sagdusmir/GasBuddy-Display-320x172/misc/3d-models/strain relief/printed part.jpg

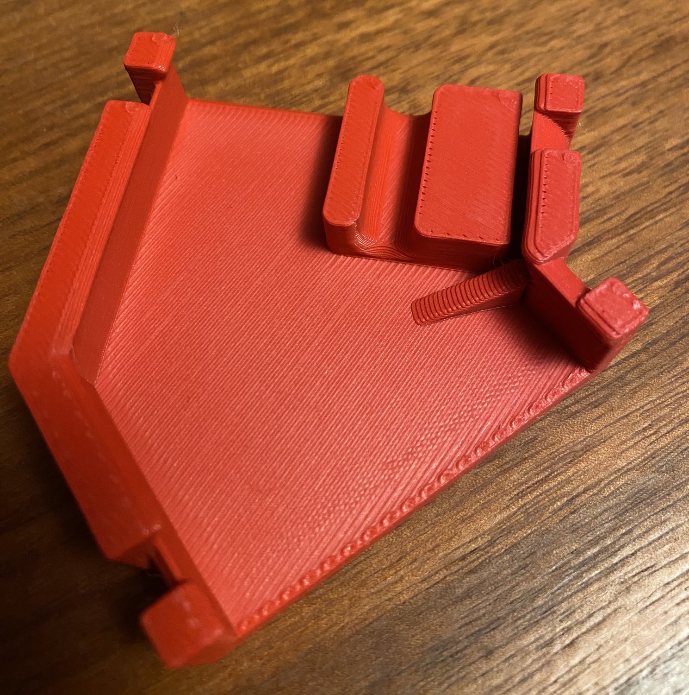
misc/3d-models/strain relief/printed part.jpg
