sagdusmir/GasBuddy-Display-320x172/misc/3d-models/strain relief/mounted part.jpg

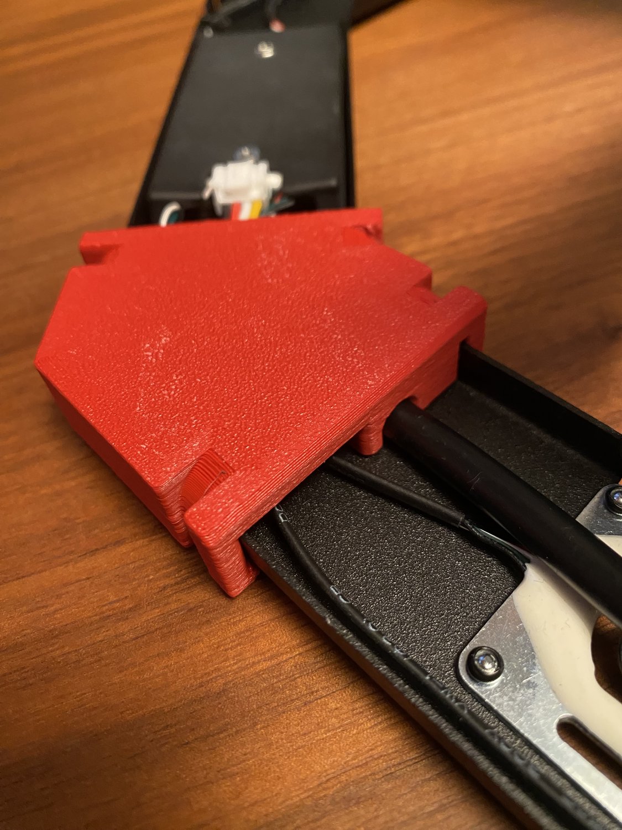
misc/3d-models/strain relief/mounted part.jpg
