sagdusmir/GasBuddy-Display-320x172/misc/3d-models/strain relief/strain relief v7.png

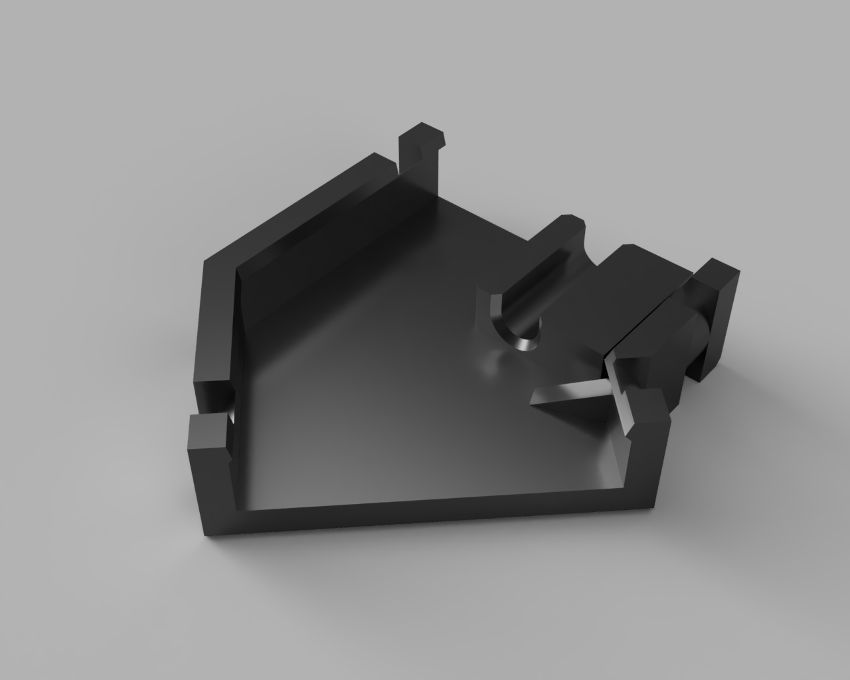
misc/3d-models/strain relief/strain relief v7.png
