sagdusmir/GasBuddy-Display-320x172/misc/part_magnetic_pogo_connector_4p_with_ear.png

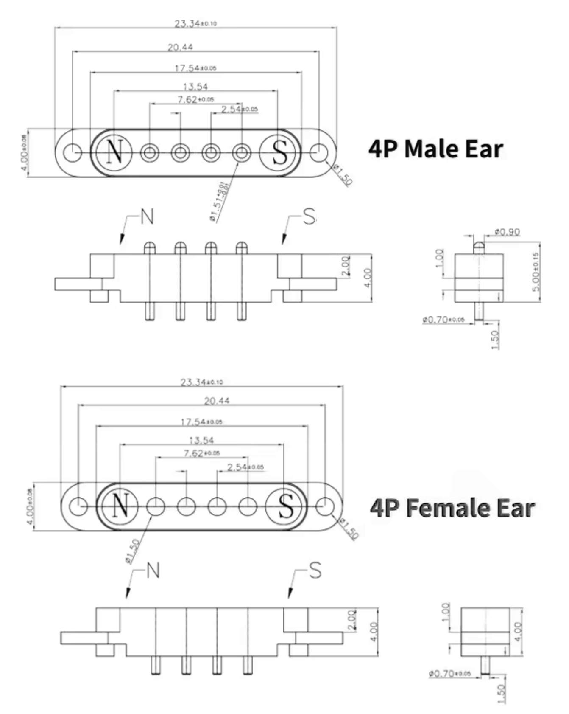
misc/part_magnetic_pogo_connector_4p_with_ear.png
