sagdusmir/GasBuddy-Display-320x172/misc/pcb-shield-v1.2/renders/top.png

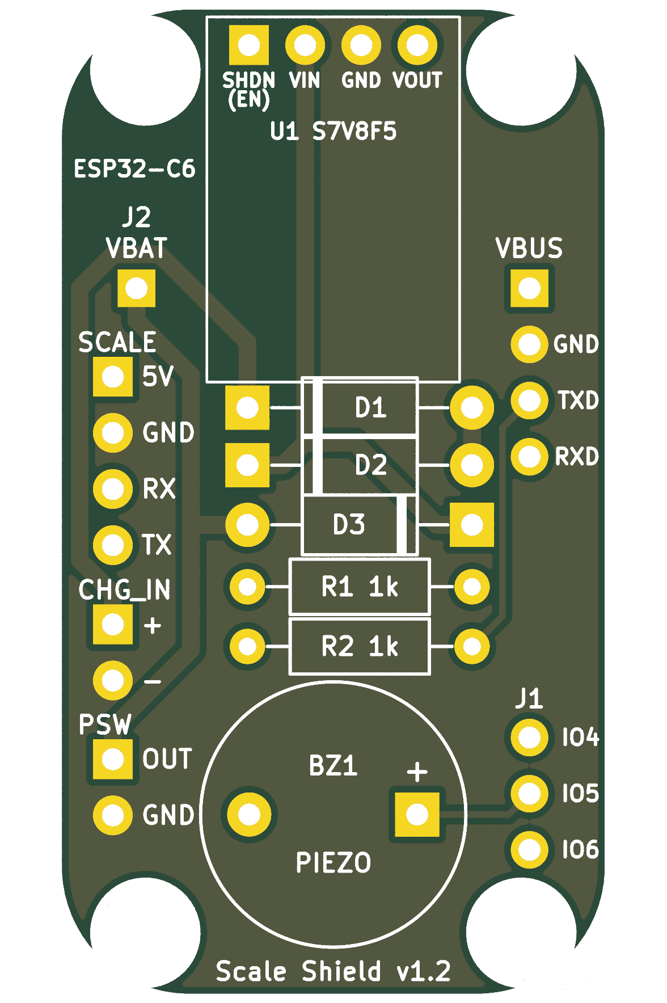
misc/pcb-shield-v1.2/renders/top.png
