sagdusmir/GasBuddy-Display-320x172/misc/3d-models/strain relief/strain relief v7.step

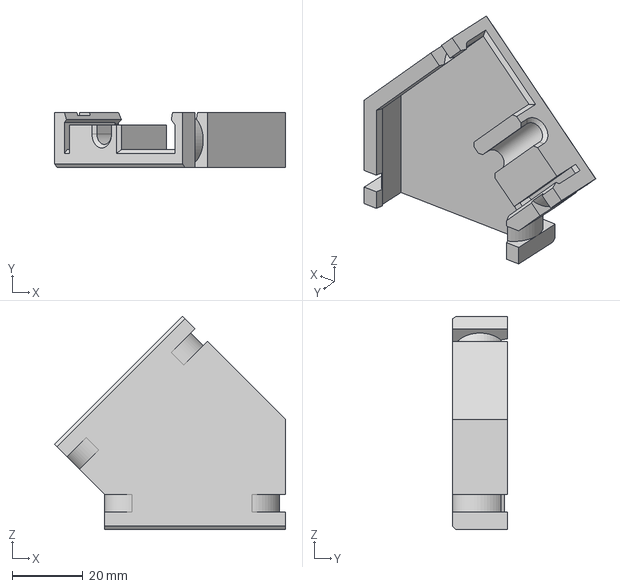
[picture p7: CAD file, 2026-11-08]
misc/3d-models/strain relief/strain relief v7.step
65.3 x 15.5 x 60.3 mm
