sagdusmir/GasBuddy-Display-320x172/(list of files, cad)

Other CAD files:
misc/3d-models/strain relief/strain relief v7.3mf
