sagdusmir/GasBuddy-Display-320x172/misc/wiring_sketch.png

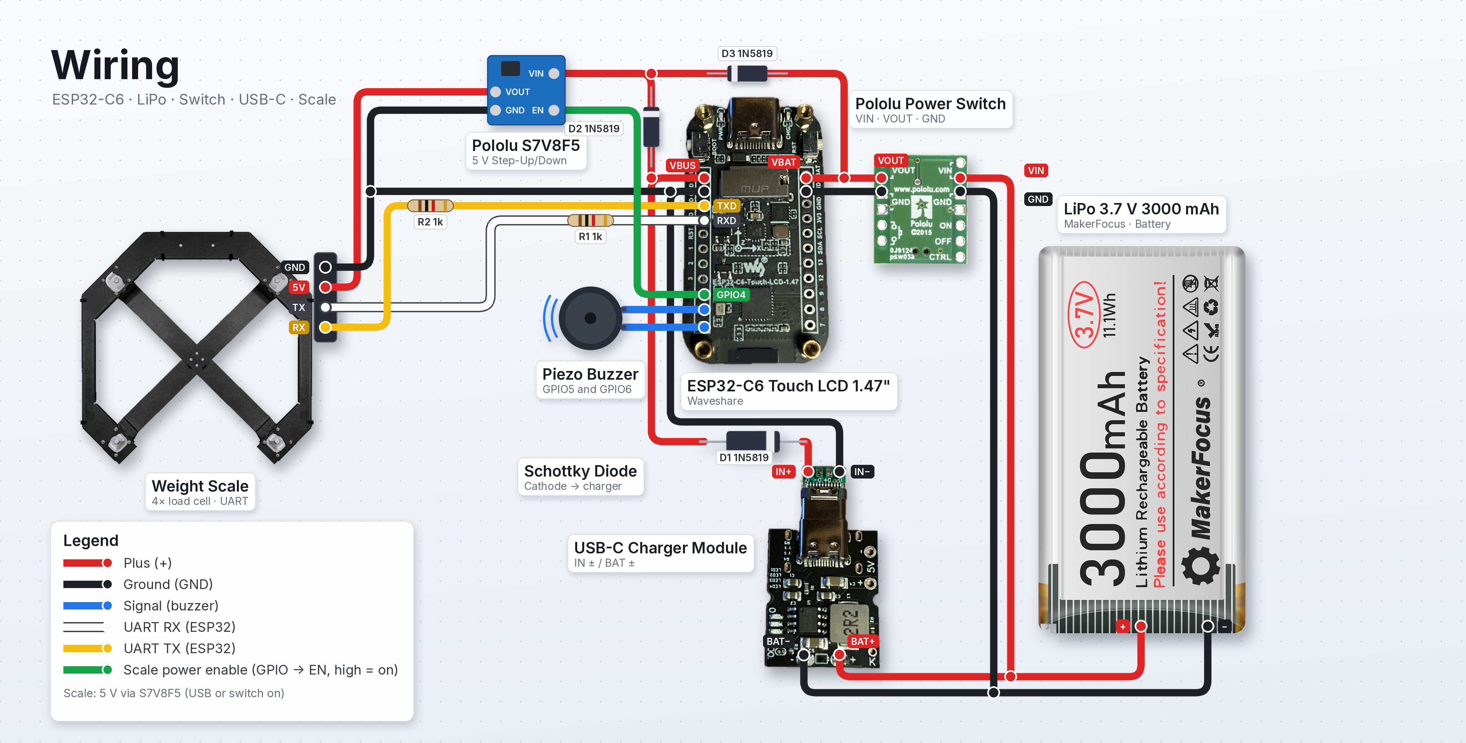
misc/wiring_sketch.png
