sagdusmir/GasBuddy-Display-320x172/misc/wiring_sketch_with_shield.png

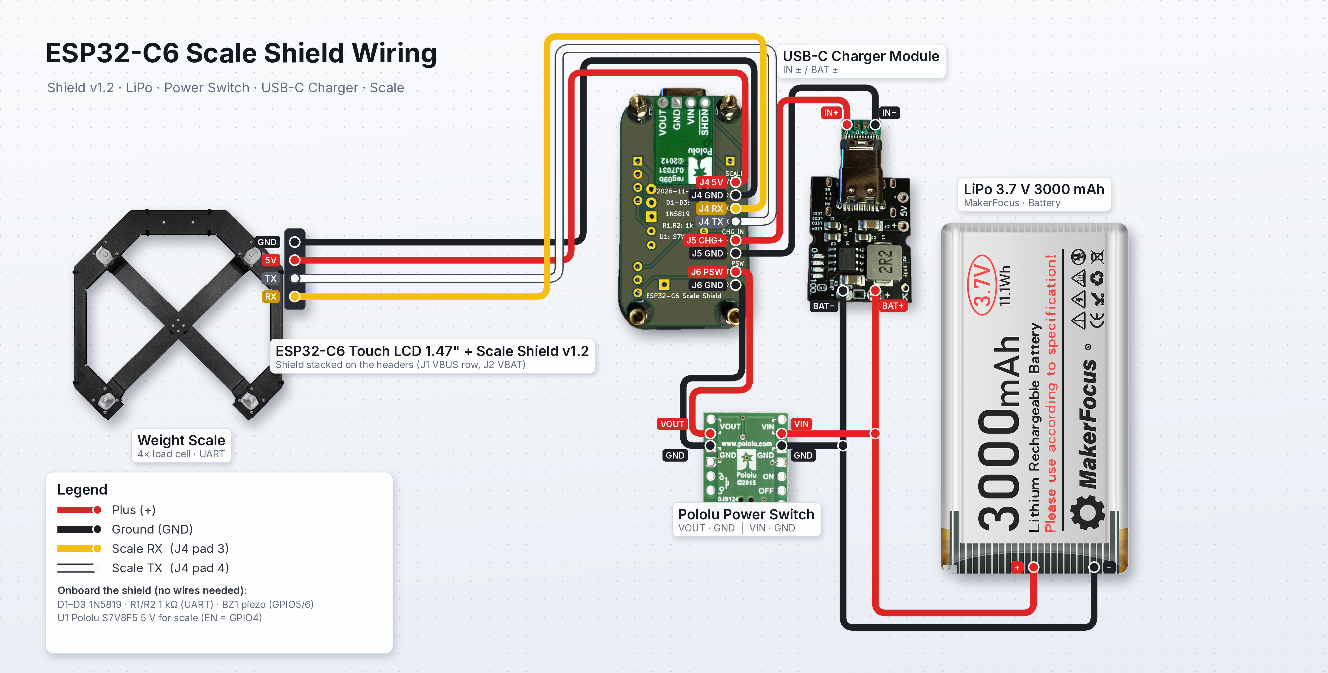
misc/wiring_sketch_with_shield.png
