sagdusmir/GasBuddy-Display-320x172/misc/wiring_sketch_with_usb_power.png

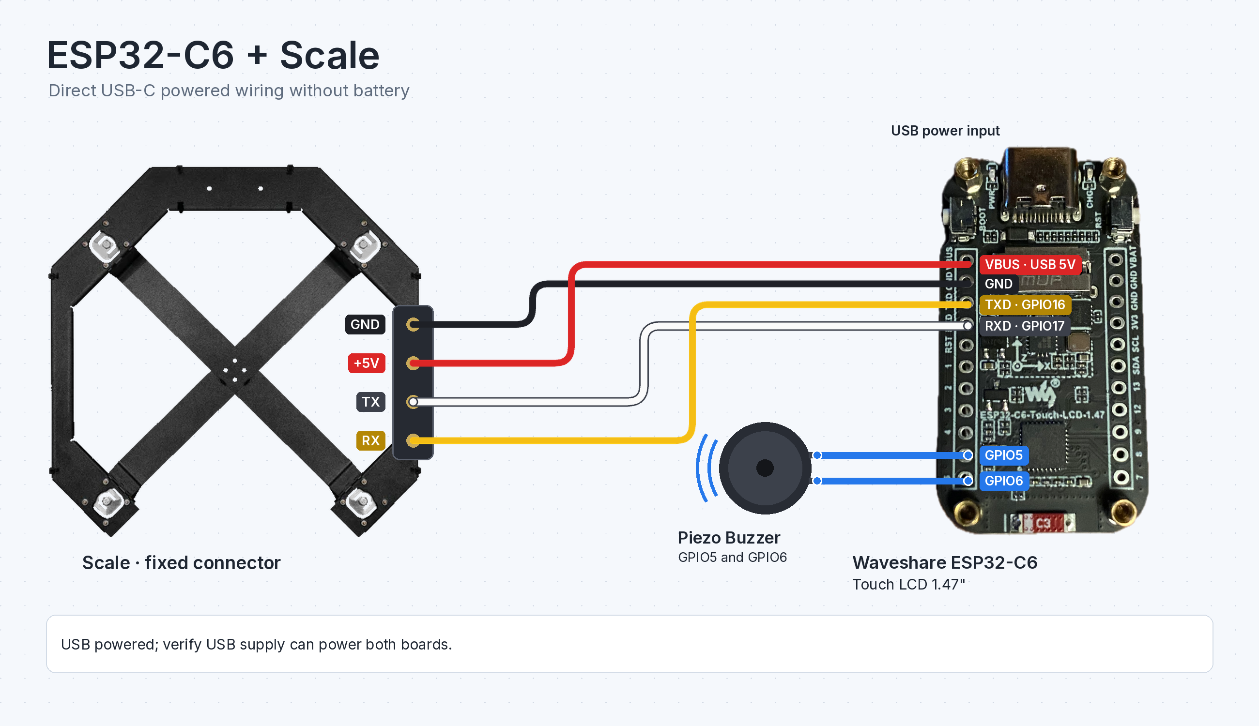
misc/wiring_sketch_with_usb_power.png
