sagdusmir/GasBuddy-Display-320x172/changelog.md

# Changelog
* [2026-11-11] GBuddy 1.1.1
   - limit the alert plays to 3
* [2026-11-11] GBuddy 1.1.0
   - more logging
   - power down the GasBuddy when the backglight is off and no reading is required (power save)
   - read the weight only once every 2 minutes when the backglight is off
* [2026-11-01] GBuddy 1.0.1
   - initial public release
   - 3d model for enclosure missing; assembly instructions unfinished

* [2026-09-13] GasBuddyDisplay 0.0.1
   - kickoff new repository
