sagdusmir/GasBuddy-Display-320x172/misc/pcb-shield-v1.2/esp32c6-scale-shield-v1.2.kicad_pcb

## KiCad design misc/pcb-shield-v1.2/esp32c6-scale-shield-v1.2.kicad_pcb (2026-11-01)

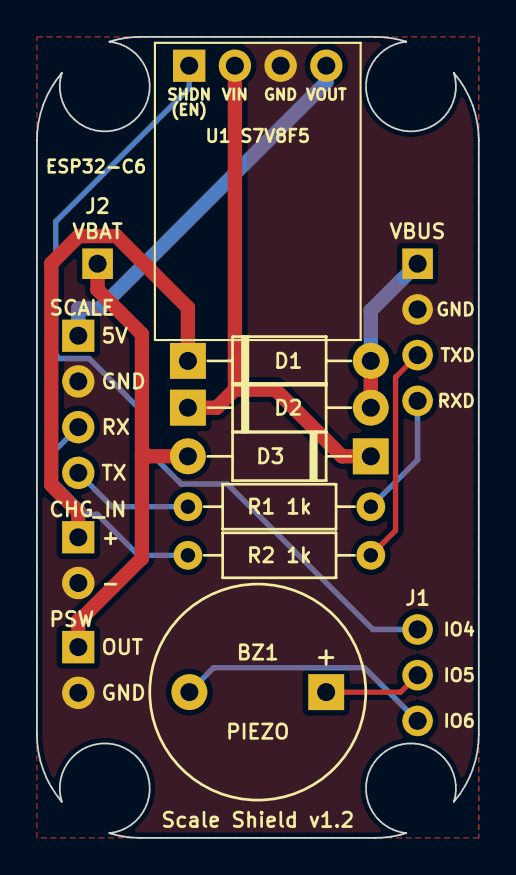
[picture p11: board esp32c6-scale-shield-v1.2.kicad_pcb from above]

Board: 2 copper layers, 24.5 x 44.5 mm, 12 parts (0 on the bottom side), 13 nets.

Parts:
BZ1: Piezo 12mm
D1, D2, D3: 1N5819
J1, J2: ESP32 header (used pins)
J4: SCALE
J5: CHG_IN
J6: PSW
R1, R2: 1k
U1: Pololu S7V8F5

Connections:
5V_IN: D2.1, D3.1, U1.2
5V_SCALE: J4.1, U1.4
CHG_IN+: D1.1, J5.1
GND: J1.2, J4.2, J5.2, J6.2, U1.3
GPIO4: J1.9, U1.1
GPIO5: BZ1.1, J1.10
GPIO6: BZ1.2, J1.11
RXD: J1.4, R1.1
SCALE_RX: J4.3, R2.2
SCALE_TX: J4.4, R1.2
TXD: J1.3, R2.1
VBAT: D3.2, J2.1, J6.1
VBUS: D1.2, D2.2, J1.1
