sagdusmir/GasBuddy-Display-320x172/gasbuddy-display.yaml

substitutions:
  # # # # # # # # # # # # # # # # # # # # # # # # # # # # # # # # # # # # # # # # #
  # You will propably need to do changes only to the following lines (if at all): #
  # # # # # # # # # # # # # # # # # # # # # # # # # # # # # # # # # # # # # # # # #

  # Name of the ESPHome device (modify if you like, avoid special characters)
  name: gasbuddy-display
  device_description: "Monitor an OW GasBuddy Scale"
  version: "GBuddy 1.1.2"

  # either pull values from secrets.yaml
  # or have it directly in this file
  wifi_ssid: !secret wifi_ssid
  wifi_password: !secret wifi_password
  # wifi_ssid: "INSERT_YOUR_WIFI_SSID"
  # wifi_password: "INSERT_YOUR_WIFI_PASSWORD"

  # Enter data of the newly created Home Assistant ESPHome device. Example:
  api_encryption_key: "BzRHwJOBQ7yfGTsoQ7Ofacsyblo9RE5gvwnRnQR1G8I="

  # over-the-air updates (ESPHome CLI or Home Assistant add-On)
  # Hint: if you changed this value on the device, you might have to alter
  # this value here to match it. esphome cli uses the value from the yaml for the ota update!
  ota_password: "8fdf9f656d36180bfba92d596c9e7db4"

  # color scheme
  SETTINGS_COLOR_SCHEME_IDX: "0"  # initially selected color scheme
  COLOR_SCHEMES: |
    //                  idx 100%      75%       50%       25%       <=25%    GOOD      BAD       LIGHT
    {                        
      {"white",         {0, 0xffffff, 0xdfdfdf, 0xbfbfbf, 0x808080, 0x808080, 0x8bff85, 0xff5757, 0xffff00}},
      {"amber",         {1, 0xffb900, 0xc08b00, 0x805d00, 0x392900, 0x392900, 0x58b100, 0xff5600, 0xffff00}},
      {"cyan",          {2, 0x68e2fb, 0x34acbf, 0x007582, 0x003c43, 0x003c43, 0x75fb8a, 0xea838d, 0xffff00}},
      {"night red",     {3, 0xff0059, 0xe0004f, 0xc00044, 0x80002e, 0x80002e, 0xff0059, 0xe4d300, 0xffff00}},
      {"green",         {4, 0x00ff00, 0x03d600, 0x058d00, 0x046f00, 0x046f00, 0x00ff00, 0xfe3a03, 0xffff00}},
      {"night blue",    {5, 0x1a00ff, 0x1700db, 0x1300b6, 0x0d007a, 0x0d007a, 0x00ff4d, 0xff0092, 0xffff00}},
      {"purple",        {6, 0xff00e4, 0xe000c8, 0xc000ac, 0x800073, 0x800073, 0x00ffb0, 0xff1100, 0xffff00}},
      {"yellow",        {7, 0xffda00, 0xc0a400, 0x806d00, 0x262000, 0x262000, 0x64dc00, 0xff5900, 0xffff00}},
      {"white (clean)", {8, 0xffffff, 0xdfdfdf, 0xbfbfbf, 0x808080, 0x000000, 0x8bff85, 0xff5757, 0xffff00}}
    }

  COLOR_SCHEME_OPTIONS:  # required for Home Assistant
    - "white"
    - "amber"
    - "cyan"
    - "night red"
    - "green"
    - "night blue"
    - "purple"
    - "yellow"
    - "white (clean)"

  FORCE_SHADOW_COLOR_TO_BLACK: 'false'  # standard: use COLOR_00 for shadows
  # FORCE_SHADOW_COLOR_TO_BLACK: 'true'  # alternative: symbol and text shadows should not be visible

  # minimum gas tank level
  SETTINGS_MIN_GAS_VALUE: "15"

  # battery SOC
  SETTINGS_HIDE_SOC: "false"
  SETTINGS_MIN_SOC_VALUE: "25"

  # Empty bottle weight, in hundredths of a kilogram (350 = 3.50 kg).
  # One hundredth is 10 g. The slider and buttons move 5 hundredths (50 g).
  CALIBRATION2_MIN_HUNDREDTHS: "350"
  CALIBRATION2_MAX_HUNDREDTHS: "1500"
  CALIBRATION2_STEP_HUNDREDTHS: "5"

  # 0: remaining gas comes from the scale. 1: the calculation uses a raw
  # count that falls over time, so the display shows a bottle losing gas.
  DEMO_MODE: "0"

  # Demo starts at 90% full and only falls. This is the top of the random
  # consumption range in g/h (the rate is uniform from 0 up to 4× this
  # value). Each rate is held for 30–75 s, with a smaller step every poll,
  # so the g/h estimate and the time-left label keep moving.
  DEMO_GRAMS_PER_HOUR: "300"

  # How many remaining-gas readings form the g/h estimate. While the
  # backlight is on the scale is polled every 5 s, so 7 readings span
  # about 30 s. With the backlight off the scale is read every 2 minutes,
  # so the same 7 readings span about 12 minutes. Minimum is 2.
  GAS_RATE_SAMPLES: "7"

  # Milliseconds the scale rail must be up before a reading. An idle
  # poll turns the regulator on, waits this long, then asks for the count.
  SCALE_SETTLE_MS: "2000"

  # No known rate, or a rate below this, leaves the live rate and hours
  # blank so the ghosts show through. "g/h", the fire icon, and the
  # hourglass use color_00 in that case. "h" uses color_00 while the
  # hours are blank.
  GAS_RATE_STABLE_LIMIT: "100"

  # interval for alarm sound
  Beeper_interval: "5s"
  # The alert tone plays this many times while gas or battery stays low,
  # then stays quiet. The count resets once both are back above their limits.
  ALERT_PLAYS: "3"

  # sounds (in RTTTL syntax):
  Wifi_Connect_Sound: "dadi:d=16,o=6,b=140:d6,32p,e6"
  Wifi_Disconnect_Sound: "siren:d=8,o=5,b=100:d,e,d,e,d,e,d,e"
  Alert_Sound: "dadidadi:d=8,o=5,b=150:d,e,d,e,d,e,d,e"
  
  # D A N G E R  Z O N E! # # # # # # # # # # # # # # # # # # # # # # # # # # # # 
  # From here on, please only make changes if you know what you are doing and   #
  # have an idea of what you want to achieve. :)                                #
  # # # # # # # # # # # # # # # # # # # # # # # # # # # # # # # # # # # # # # # #

  # shades of white (initial start values since substitutions work best)
  COLOR_100:   "0xffffff"  # 100% brightness
  COLOR_75:    "0xbfbfbf"  #  75%
  COLOR_50:    "0x808080"  #  50%
  COLOR_25:    "0x404040"  #  25%
  COLOR_00:    "0x404040"  # shadows
  COLOR_GOOD:  "0x8bff85"
  COLOR_BAD:   "0xff5757"
  COLOR_LIGHT: "0xffff00"

esphome:
  name: ${name}
  build_path: /tmp/esphome_build/${name}
  min_version: "2026.8.2"

  project:
    name: "gasbuddy.display320_172"
    version: ${version}

  on_boot:
    # priority: 1100 # stay above 1000 and below 1500!  # CHANGE FOR MINI
    then:
      - output.turn_on: scale_power
      - lambda: |-
          id(boot_start_time) = millis();
          id(scale_powered_at) = millis();
          id(scale_rail_on) = true;
          id(backlight_on) = true;
      - light.turn_on: backlight

esp32:
  board: esp32-c6-devkitc-1
  # variant: esp32c6  # use either board: or variant
  flash_size: 8MB
  framework:
    type: esp-idf
    sdkconfig_options:
      # CONFIG_ESP_TASK_WDT_EN: n  # Disables Task Watchdog Timer (TWDT)
      CONFIG_ESP_INT_WDT: "n"      # Disables Interrupt Watchdog Timer (IWDT)
      # COMPILER_OPTIMIZATION_SIZE: "y"  # optimize for size
      CONFIG_COMPILER_OPTIMIZATION_PERF: "y"
      CONFIG_ESP32S3_DEFAULT_CPU_FREQ_240: "y"
      CONFIG_ESP32S3_DATA_CACHE_64KB: "y"
      CONFIG_ESP32S3_DATA_CACHE_LINE_64B: "y"
      CONFIG_SPIRAM_FETCH_INSTRUCTIONS: "y"
      CONFIG_SPIRAM_RODATA: "y"
      CONFIG_ESP_WIFI_TASK_CORE_ID: "0"
      CONFIG_TCPIP_TASK_CORE_ID: "0"
      CONFIG_ESP_TIMER_TASK_CORE_ID: "0"
      CONFIG_ESP_MAIN_TASK_AFFINITY_CPU1: "y"

# psram:   # CHANGE FOR MINI
#   mode: octal
#   speed: 80MHz

logger:
  # baud_rate: 921600  # enable logging
  baud_rate: 0  # no logging -> saves power

api: # enable Home Assistant API
  max_connections: 5
  encryption:
    key: ${api_encryption_key}
  reboot_timeout: 0s  

ota:
  - platform: esphome
    id: my_ota
    password: ${ota_password}

wifi:
  id: my_wifi
  ssid: ${wifi_ssid}
  password: ${wifi_password}
  fast_connect: False
  reboot_timeout: 0s
  on_connect:
    then:
      - rtttl.play: ${Wifi_Connect_Sound}
      - lambda: |-
          id(current_ip_address) = id(wifi_ip_sensor).state.c_str();
      - globals.set:
          id: wifi_connected
          value: 'true'
      - globals.set:
          id: apply_wifi_started_by_user
          value: 'false'
      - lvgl.widget.refresh: wifi_connect_label
      - lvgl.widget.refresh: current_wifi_ip_label
  on_disconnect:
    then:
      - rtttl.play: ${Wifi_Disconnect_Sound}
      - globals.set:
          id: wifi_connected
          value: 'false'
      - globals.set:
          id: current_ip_address
          value: '" "'  # not connected
      - lvgl.widget.refresh: wifi_connect_label
      - lvgl.widget.refresh: current_wifi_ip_label

# External Components
external_components:
  - source: github://widget/esphome-components
    components: [axs5106]
    refresh: 0s


i2c: # used for touchscreen
  - id: touchscreen_bus
    sda: GPIO18
    scl: GPIO19
    frequency: 400kHz
    scan: false
  # I2C Bus:
  #   SDA Pin: GPIO18
  #   SCL Pin: GPIO19
  #   Frequency: 400000 Hz
  #   Recovery: bus successfully recovered
  # Results from bus scan:
  # Found device at address 0x63
  # Found device at address 0x6B

# Touchscreen
touchscreen:
  - platform: axs5106
    id: my_touchscreen
    i2c_id: touchscreen_bus
    interrupt_pin: GPIO21
    reset_pin: GPIO20
    calibration:
      x_min: 0
      y_min: 0
      y_max: 172
      x_max: 320
    transform:
      swap_xy: true
      mirror_x: true
      mirror_y: true
    # for test purposes, touch coordinates can be logged
    # on_touch:
    #     - lambda: |-
    #         ESP_LOGI("Touch", "Touch detected at x=%d, y=%d", touch.x, touch.y);
    on_release:
      - if:
          condition: lvgl.is_paused
          then:
            - logger.log: "Display is resuming"
            - lvgl.resume:
            - lvgl.widget.redraw:
            - light.turn_on: backlight
            - lambda: id(backlight_on) = true;
            - script.execute: scale_power_on
            - if:
                condition:
                  lambda: 'return !${DEMO_MODE};'
                then:
                  - script.execute: reset_gas_consumption

spi:  # used for display
  clk_pin: GPIO1
  mosi_pin: GPIO2

display:
  - platform: mipi_spi
    id: my_display
    model: ST7789V
    dc_pin: GPIO15
    cs_pin: GPIO14
    reset_pin: GPIO22
    dimensions:
      width: 320
      height: 172
      offset_height: 34
      offset_width: 0
    transform:
      swap_xy: true
      mirror_x: true
      mirror_y: true
    invert_colors: false
    data_rate: 80MHz
    color_order: bgr
    # USB flash resets the ESP32-C6 only. GPIO22 is pulsed for 5ms and,
    # because a reset pin is set, ESPHome never sends SWRESET. The JD9853
    # then keeps garbage until power is removed. Reset in software, wait
    # out the panel's 120ms, and send the ST7789V setup registers again.
    # 0x36 and 0x3A stay out of this list: transform is set, and the driver
    # appends pixel format, invert, sleep-out, and display-on itself.
    init_sequence:
      - [0x01]  # SWRESET
      - delay 120ms
      - [0xB6, 0x0A, 0x82]
      - [0xB2, 0x0C, 0x0C, 0x00, 0x33, 0x33]
      - [0xB7, 0x35]
      - [0xBB, 0x28]
      - [0xC0, 0x0C]
      - [0xC2, 0x01, 0xFF]
      - [0xC3, 0x10]
      - [0xC4, 0x20]
      - [0xC6, 0x0F]
      - [0xD0, 0xA4, 0xA1]
      - [0xE0, 0xD0, 0x00, 0x02, 0x07, 0x0A, 0x28, 0x32, 0x44, 0x42, 0x06, 0x0E, 0x12, 0x14, 0x17]
      - [0xE1, 0xD0, 0x00, 0x02, 0x07, 0x0A, 0x28, 0x31, 0x54, 0x47, 0x0E, 0x1C, 0x17, 0x1B, 0x1E]
    # update_interval: 1s
    
output:
  - platform: ledc
    id: gpio_backlight_pwm
    pin: GPIO23

  - id: helper_low_beeper
    platform: ledc
    pin: GPIO6
  - platform: ledc
    id: rtttl_out
    pin: GPIO5

  # Scale power enable (S7V8F5 SHDN). High = 5 V rail on.
  # The rail stays on while the backlight is on. While the backlight is
  # off it is on only for one settled reading every 2 minutes.
  - platform: gpio
    id: scale_power
    pin: GPIO4

light:
  - id: backlight
    name: Backlight
    platform: monochromatic
    output: gpio_backlight_pwm
    restore_mode: ALWAYS_ON
    internal: true

rtttl:
  id: my_rtttl
  output: rtttl_out
  gain: 80%

# GasBuddy scale (STM32 on the 4-pin lead: GND, +5V, RX, TX).
# Same poll as the grill: 9600 8N1, command AA 14 C3 3C.
# Parsed field is reply bytes [2:3], big-endian. It is probably the 
# raw count only, because the scale is uncalibrated.
# Logger stays on USB Serial/JTAG, so the header UART is free.
# GPIO16 = ESP_TXD -> scale RX, GPIO17 = ESP_RXD <- scale TX.
# Grill GPIO2/GPIO15 are the LCD on this board, so they are not used here.
uart:
  id: uart_gasbuddy
  tx_pin: GPIO16
  rx_pin: GPIO17
  baud_rate: 9600

interval:
  - interval: 10s
    then:
      - lvgl.widget.refresh: warning_on_label
  - interval: ${Beeper_interval}
    then:
      - lambda: |-
          // Match the warning icon: stay quiet for the first 15s after boot.
          if (millis() - id(boot_start_time) < 15000) {
            return;
          }
          bool soc_low = id(battery_soc_seen)
            && (id(battery_soc_value) <= id(settings_min_soc_value_persistent));
          bool gas_low = id(gas_percent_seen)
            && (id(gas_percent) <= id(settings_min_gas_value_persistent));
          if (!(soc_low || gas_low)) {
            id(alert_plays) = 0;
            return;
          }
          if (id(alert_plays) >= ${ALERT_PLAYS}) {
            return;
          }
          id(alert_plays)++;
          id(my_rtttl).play("${Alert_Sound}");
  - interval: 1s
    then:
      - if:
          condition:
            and:
              - lambda: return !id(boot_screen_color_scheme_init);
          then:
            - lambda: |-
                id(boot_screen_color_scheme_init) = true;
                id(apply_color_scheme).execute();

      - if:
          condition:
            and:
              - lambda: 'return !id(boot_screen_hidden);'
              - lambda: 'return millis() - id(boot_start_time) >= 2000;'
          then:
            - script.execute: hide_boot_screen

  - interval: 5s
    then:
      - if:
          condition:
            lambda: |-
              // Demo keeps this cadence with the backlight off, and it
              // does not switch the scale rail.
              if (${DEMO_MODE}) {
                return true;
              }
              if (!id(backlight_on) && !id(scale_hold)) {
                return false;
              }
              if (!id(scale_rail_on)) {
                return false;
              }
              if (millis() - id(scale_powered_at) < ${SCALE_SETTLE_MS}) {
                return false;
              }
              return true;
          then:
            - script.execute: poll_gas_scale

  # One settled reading every 2 minutes while the backlight is off.
  - interval: 2min
    then:
      - if:
          condition:
            lambda: 'return !${DEMO_MODE} && !id(backlight_on) && !id(scale_hold);'
          then:
            - lambda: 'ESP_LOGI("uart_gasbuddy", "Idle scale reading");'
            - script.execute: scale_power_on
            - delay: ${SCALE_SETTLE_MS}ms
            - if:
                condition:
                  lambda: 'return !id(backlight_on) && !id(scale_hold);'
                then:
                  # poll_gas_scale turns the rail off after the reply.
                  # Do not turn it off here: script.execute returns as soon
                  # as that script hits its 100 ms wait, so a power-off in
                  # this list would kill the rail before the scale answers.
                  - script.execute: poll_gas_scale

globals:
  - id: wifi_connected
    type: bool
    initial_value: 'false'
  - id: warning_on
    type: bool
    initial_value: 'false'
  # Alert tones already played for the current low-gas or low-battery episode.
  - id: alert_plays
    type: int
    restore_value: no
    initial_value: '0'
  - id: gas_weight
    type: int32_t
    initial_value: '-1'

  # Bumped when the calibration wizard closes with Done, and when the
  # backlight turns on or off, so the g/h window does not mix the 5 s
  # samples with the 2-minute samples.
  - id: gas_rate_epoch
    type: int
    restore_value: no
    initial_value: '0'
  - id: gas_rate_g_per_h
    type: float
    restore_value: no
    initial_value: '0'
  - id: gas_rate_known
    type: bool
    restore_value: no
    initial_value: 'false'
  - id: gas_time_h
    type: float
    restore_value: no
    initial_value: '0'
  - id: gas_time_known
    type: bool
    restore_value: no
    initial_value: 'false'

  # Backlight is on from boot. Idle clears it; a touch sets it again.
  - id: backlight_on
    type: bool
    restore_value: no
    initial_value: 'true'
  # Calibration pages keep the rail on even if the backlight times out,
  # so Continue and Done do not store a stale raw count.
  - id: scale_hold
    type: bool
    restore_value: no
    initial_value: 'false'
  # True while GPIO4 is driving the regulator on.
  - id: scale_rail_on
    type: bool
    restore_value: no
    initial_value: 'false'
  # millis() when the rail last went from off to on. Polls wait
  # SCALE_SETTLE_MS after this.
  - id: scale_powered_at
    type: uint32_t
    restore_value: no
    initial_value: '0'

  # Raw GasBuddy UART reading (reply bytes [2:3]). Not published.
  - id: uart_gas_value
    type: int32_t
    initial_value: '-1'

  - id: gas_percent
    type: int32_t
    initial_value: '0'
  - id: gas_percent_seen
    type: bool
    initial_value: 'false'
  - id: apply_wifi_started_by_user  # for supressing sounds
    type: bool
    initial_value: 'false'

  - id: color_schemes
    type: std::map<std::string, std::vector<uint32_t>>
    initial_value: '${COLOR_SCHEMES}'
  - id: color_100
    type: int
    initial_value: '0x000000'
  - id: color_75
    type: int
    initial_value: '0x000000'
  - id: color_50
    type: int
    initial_value: '0x000000'
  - id: color_25
    type: int
    initial_value: '0x000000'
  - id: color_00
    type: int
    initial_value: '0x000000'
  - id: color_good
    type: int
    initial_value: '0x000000'
  - id: color_bad
    type: int
    initial_value: '0x000000'
  - id: color_light
    type: int
    initial_value: '0x000000'

  - id: boot_start_time
    type: uint32_t
    initial_value: '0'
  - id: boot_screen_hidden
    type: bool
    initial_value: 'false'
  - id: boot_screen_color_scheme_init
    type: bool
    initial_value: 'false'

  - id: battery_soc_value
    type: int
    initial_value: '0'
  - id: battery_soc_seen
    type: bool
    initial_value: 'false'

  - id: settings_min_gas_value_persistent
    type: int
    initial_value: '${SETTINGS_MIN_GAS_VALUE}'
    restore_value: true
  - id: settings_min_soc_value_persistent
    type: int
    initial_value: '${SETTINGS_MIN_SOC_VALUE}'
    restore_value: true
  - id: settings_hide_soc_persistent
    type: bool
    initial_value: '${SETTINGS_HIDE_SOC}'
    restore_value: true
  - id: settings_display_timeout_value_persistent
    type: int
    initial_value: '30'
    restore_value: true
  - id: settings_color_scheme_idx_persistent
    type: int
    initial_value: '${SETTINGS_COLOR_SCHEME_IDX}'
    restore_value: true
  # Raw load-cell count with nothing on the platform. Not a kilogram value.
  - id: settings_scale_raw_zero_persistent
    type: int
    initial_value: '0'
    restore_value: true
  # Raw load-cell count with the new bottle on the platform.
  - id: settings_scale_brutto_persistent
    type: int
    initial_value: '0'
    restore_value: true
  - id: settings_scale_bottle_kg_persistent
    type: int
    initial_value: '11'
    restore_value: true
  # Empty-bottle weight in hundredths of a kilogram (1000 = 10.00 kg).
  - id: calibration2_hundredths_persisted
    type: int
    initial_value: '1000'
    restore_value: true

  - id: current_ip_address
    type: std::string
    initial_value: '" "'  # not connected
  # Working copies are loaded when the wizard opens. Persisted values are
  # written only on the last calibration page, so leaving earlier does not
  # replace a finished calibration.
  - id: settings_scale_raw_zero
    type: int
    initial_value: '0'
  - id: settings_scale_bottle_kg
    type: int
    initial_value: '0'
  # Hundredths of a kilogram shown on calibration2_page. Loaded from
  # calibration2_hundredths_persisted when the wizard opens.
  - id: calibration2_hundredths
    type: int
    initial_value: '1000'
  # Choices for the bottle-size buttons. Button text is the value itself.
  - id: scale_bottle_kg_options
    type: std::array<int, 3>
    initial_value: '{5, 8, 11}'

text_sensor:
  - platform: wifi_info
    ip_address:
      id: wifi_ip_sensor

  - platform: template
    name: "Software Version"
    lambda: |-
      return std::string("${version}");

select:
  - platform: template
    id: color_scheme_select
    name: "Color Scheme"
    optimistic: true
    options: ${COLOR_SCHEME_OPTIONS}
    on_value:
      - lambda: |-
          for (const auto& pair : id(color_schemes)) {
            if (pair.first == x) {
              id(settings_color_scheme_idx_persistent) = static_cast<int>(pair.second[0]);
              id(apply_color_scheme).execute();
              break;
            }
          }

switch:
  - platform: template
    name: "Hide Battery SOC"
    id: hide_soc_switch
    optimistic: true
    on_turn_on:
      - lambda: id(settings_hide_soc_persistent) = true;
      - lvgl.widget.refresh: battery_symbol_obj
    on_turn_off:
      - lambda: id(settings_hide_soc_persistent) = false;
      - lvgl.widget.refresh: battery_symbol_obj

number:
  - platform: template
    name: "Min Gas Value"
    id: min_gas_value_number
    optimistic: true
    min_value: 5
    max_value: 60
    step: 5
    unit_of_measurement: "%"
    initial_value: 20.0
    on_value:
      - lambda: id(settings_min_gas_value_persistent) = int(x);
      - lvgl.widget.refresh: [warning_on_label, gas_percent_bar, gas_warning_label2, gas_warning_mark]

  - platform: template
    name: "Min Battery SOC Value"
    id: min_soc_value_number
    optimistic: true
    min_value: 5
    max_value: 50
    step: 10
    unit_of_measurement: "%"
    initial_value: 40.0
    on_value:
      - lambda: id(settings_min_soc_value_persistent) = int(x);
      - lvgl.widget.refresh: [warning_on_label, battery_symbol, soc_warning_label2]

font:
  - file: 'https://raw.githubusercontent.com/sagdusmir/GasBuddy-Display-320x172/main/fonts/MaterialDesign-Webfont/materialdesignicons-webfont.ttf'
    # file: 'fonts/MaterialDesign-Webfont/materialdesignicons-webfont.ttf'
    id: ICON_FONT_30
    size: 30
    glyphs:
      - "\U000F0415" # mdi-plus
      - "\U000F0374" # mdi-minus
  - file: 'https://raw.githubusercontent.com/sagdusmir/GasBuddy-Display-320x172/main/fonts/MaterialDesign-Webfont/materialdesignicons-webfont.ttf'
    # file: 'fonts/MaterialDesign-Webfont/materialdesignicons-webfont.ttf'
    id: ICON_FONT_39
    size: 39
    glyphs:
      - "\U000F1358" # mdi-propane-tank-outline
  - file: 'https://raw.githubusercontent.com/sagdusmir/GasBuddy-Display-320x172/main/fonts/MaterialDesign-Webfont/materialdesignicons-webfont.ttf'
    # file: 'fonts/MaterialDesign-Webfont/materialdesignicons-webfont.ttf'
    id: ICON_FONT_27
    size: 27
    glyphs:
      - "\U000F0493" # mdi-cog
  - file: 'https://raw.githubusercontent.com/sagdusmir/GasBuddy-Display-320x172/main/fonts/MaterialDesign-Webfont/materialdesignicons-webfont.ttf'
    # file: 'fonts/MaterialDesign-Webfont/materialdesignicons-webfont.ttf'
    id: ICON_FONT_29
    size: 29
    glyphs:
      - "\U000F0D3F" # mdi-weight-gram
  - file: 'https://raw.githubusercontent.com/sagdusmir/GasBuddy-Display-320x172/main/fonts/DESG07/DSEG7ClassicMini-Bold.ttf'
    # file: 'fonts/DESG07/DSEG7ClassicMini-Bold.ttf'
    id: SEGMENT_FONT_65
    size: 65
    glyphs:
      - "0"
      - "1"
      - "2"
      - "3"
      - "4"
      - "5"
      - "6"
      - "7"
      - "8"
      - "9"
      - "-"
      - " "
  - file: 'https://raw.githubusercontent.com/sagdusmir/GasBuddy-Display-320x172/main/fonts/DESG07/DSEG7ClassicMini-Bold.ttf'
    # file: 'fonts/DESG07/DSEG7ClassicMini-Bold.ttf'
    id: SEGMENT_FONT_24
    size: 24
    glyphs:
      - "0"
      - "1"
      - "2"
      - "3"
      - "4"
      - "5"
      - "6"
      - "7"
      - "8"
      - "9"
      - "."
      - "-"
  - file: 'https://raw.githubusercontent.com/sagdusmir/GasBuddy-Display-320x172/main/fonts/MaterialDesign-Webfont/materialdesignicons-webfont.ttf'
    # file: 'fonts/MaterialDesign-Webfont/materialdesignicons-webfont.ttf'
    id: ICON_FONT_22
    size: 22
    glyphs:
      - "\U000F06AD" # mdi-timer-sand-empty
      - "\U000F0238" # mdi-fire
  - file: 'https://raw.githubusercontent.com/sagdusmir/GasBuddy-Display-320x172/main/fonts/Montserrat/Montserrat-Bold.ttf'
    # file: 'fonts/Montserrat/Montserrat-Bold.ttf'
    id: MONTSERRAT_BOLD_FONT_18
    size: 18
    glyphs:
      - "0"
      - "1"
      - "2"
      - "3"
      - "4"
      - "5"
      - "6"
      - "7"
      - "8"
      - "9"
      - " "
      - "-"
      - "("
      - ")"
      - "a"
      - "b"
      - "c"
      - "d"
      - "e"
      - "f"
      - "g"
      - "h"
      - "i"
      - "j"
      - "k"
      - "l"
      - "m"
      - "n"
      - "o"
      - "p"
      - "q"
      - "r"
      - "s"
      - "t"
      - "u"
      - "v"
      - "w"
      - "x"
      - "y"
      - "z"

lvgl:
  buffer_size: 50%
  displays: my_display
  touchscreens: my_touchscreen
  bg_color: 0
  border_width: 0
  outline_width: 0
  theme:
    label:
      bg_color: 0
      bg_opa: COVER
      width: 120
      text_align: CENTER
    bar:
      radius: 5
      indicator:
        radius: 5
        arc_color: red
    arc:
      radius: 5
      indicator:
        arc_rounded: false
        radius: 5
    roller:
      text_font: MONTSERRAT_20
      width: 60
      selected:
        text_font: MONTSERRAT_BOLD_FONT_18
    button:
      border_width: 0
      radius: 0
    slider:
      bg_opa: COVER
      radius: 0
      adv_hittest: true
      border_width: 0
      indicator:
        radius: 0
      knob:
        radius: 2

    textarea:
      width: 340
      height: 30
      text_font: MONTSERRAT_18
      border_width: 1
    keyboard:
      text_color: ${COLOR_100}
      bg_color: ${COLOR_25}
      items:
        bg_color: ${COLOR_100}
        text_color: ${COLOR_25}

  # send display to idle state after timeout
  on_idle:
    timeout: !lambda "return(id(settings_display_timeout_value_persistent) * 1000);"
    then:
    - if:
        condition:
          - lambda: "return id(settings_display_timeout_value_persistent) > 0;"
        then:
          - logger.log: "Display is idle"
          - light.turn_off: backlight
          - lvgl.pause:
          - lambda: id(backlight_on) = false;
          - script.execute: scale_power_off_if_idle
          - if:
              condition:
                lambda: 'return !${DEMO_MODE};'
              then:
                - script.execute: reset_gas_consumption

  # boot screen with spinner - just for fun
  top_layer:
    widgets:
      - obj:
          id: boot_screen
          x: 0
          y: 0
          width: 320
          height: 172
          bg_color: 0
          bg_opa: COVER
          radius: 0
          pad_all: 0
          border_width: 0
          widgets:
            - spinner:
                id: boot_spinner
                align: CENTER
                spin_time: 1s
                arc_length: 60deg
                arc_width: 4
                arc_color: 0
                indicator:
                  arc_color: 0  # overridden after color scheme is known
                  arc_width: 4

      - obj:
          id: status_bar_top
          x: 0
          y: 0
          width: 320
          height: 30
          bg_color: 0
          bg_opa: COVER
          pad_all: 0
          border_width: 0
          hidden: true
          radius: 0
          widgets:            
            - obj: # horizontal battery icon
                id: battery_symbol_obj
                x: 287
                y: 0
                width: 30
                height: 27
                bg_color: 0
                pad_all: 0
                outline_width: 0
                border_width: 0
                border_side: NONE
                radius: 0
                hidden: !lambda |-
                  return id(settings_hide_soc_persistent);
                widgets:
                  - label:
                      id: battery_symbol
                      x: 0
                      y: 0
                      text_font: MONTSERRAT_24
                      text_align: LEFT
                      width: 30
                      text_color: !lambda |-
                        if( id(battery_soc_value) <= id(settings_min_soc_value_persistent) ) {
                          return lv_color_hex(id(color_bad));
                        }
                        return lv_color_hex(id(color_good));
                      text: !lambda |-
                        const char* icons[5] = {"\U0000F244","\U0000F243","\U0000F242","\U0000F241","\U0000F240"};
                        float soc = id(battery_soc_value);
                        int idx = soc <= 15 ? 0 :
                            soc <= 40 ? 1 :
                            soc <= 60 ? 2 :
                            soc <= 80 ? 3 : 4;
                        return icons[idx];
            - label: # symbol for successfull WIFI connection
                id: wifi_connect_label
                x: 255
                y: 1
                text_font: MONTSERRAT_20
                text_align: LEFT
                width: 26
                text_color: !lambda |-
                  if( id(wifi_connected) ) {
                    return lv_color_hex(id(color_good));
                  }
                  return lv_color_hex(id(color_00));
                text: "\uF1EB" # WIFI symbol
            - label:
                id: warning_on_label
                x: 228
                y: 2
                text_font: MONTSERRAT_20
                text_color: !lambda |-
                  if (millis() - id(boot_start_time) < 15000) {
                    // first 15 seconds after boot: no warning
                    return lv_color_hex(id(color_00));
                  }
                  if((id(battery_soc_value) <= id(settings_min_soc_value_persistent))
                    || id(warning_on)
                    || (id(gas_percent) <= id(settings_min_gas_value_persistent))
                  ) {
                    return lv_color_hex(id(color_bad));
                  }
                  return lv_color_hex(id(color_00));
                text_align: LEFT
                width: 24
                text: "\uF071"
            - label: # catch clicks
                x: 0
                y: 0
                width: 320
                height: 30
                bg_opa: TRANSP
                pad_all: 0
                border_width: 0
                radius: 0
                clickable: true
                text: " "
                on_press:
                  - script.execute: toggle_settings_page

  pages:
    - id: scale_page
      bg_color: 0x000000
      bg_opa: COVER
      pad_all: 0
      scrollable: false
      on_load:
        then:
          - lambda: id(scale_hold) = false;
          - script.execute: scale_power_off_if_idle
      widgets:
        - label:
            id: weight_label_background
            align: TOP_LEFT
            x: 0
            y: 34
            width: 265
            bg_color: 0x000000
            bg_opa: COVER
            pad_all: 0
            border_width: 0
            text_font: SEGMENT_FONT_65
            text_align: RIGHT
            text_color: !lambda return lv_color_hex(id(color_25));
            text: "18888"
        - label:
            id: weight_label
            align: TOP_LEFT
            x: 0
            y: 34
            width: 265
            bg_opa: TRANSP
            pad_all: 0
            border_width: 0
            text_font: SEGMENT_FONT_65
            text_align: RIGHT
            text_color: !lambda return lv_color_hex(id(color_100));
            text: !lambda |-
              int v = id(gas_weight);
              if (v < 0) {
                return "---";
              }
              return to_string(v).c_str();
        - label:
            id: weight_unit
            align: TOP_LEFT
            x: 277
            y: 73
            width: 29
            bg_color: 0x000000
            bg_opa: COVER
            pad_all: 0
            border_width: 0
            text_font: ICON_FONT_29
            text_align: RIGHT
            text_color: !lambda return lv_color_hex(id(color_100));
            text: "\U000F0D3F"
        - obj:
            id: gas_level_obj
            x: 14
            y: 111
            width: 292
            height: 18
            pad_all: 0
            scrollable: false
            overflow_visible: true
            bg_opa: TRANSP
            border_width: 0
            radius: 0
            hidden: !lambda |-
              return false;
            widgets:
              # Old frame fill. The warning mark is drawn after this, so its
              # lips stay visible, and the bar and dividers cover the middle.
              - obj:
                  x: 0
                  y: 2
                  width: 292
                  height: 14
                  bg_color: 0x000000
                  bg_opa: COVER
                  border_width: 0
                  radius: 0
                  pad_all: 0
                  scrollable: false
                  clickable: false
              - obj:
                  id: gas_warning_mark
                  x: -2
                  y: 0
                  height: 18
                  width: !lambda |-
                    int level = id(settings_min_gas_value_persistent);
                    if (level < 0) {
                      level = 0;
                    }
                    if (level > 100) {
                      level = 100;
                    }
                    return level * 290 / 100 + 3;
                  hidden: !lambda |-
                    return id(settings_min_gas_value_persistent) <= 0;
                  bg_opa: COVER
                  bg_color: !lambda return lv_color_hex(id(color_100));
                  border_width: 0
                  radius: 0
                  pad_all: 0
                  scrollable: false
              - bar:
                  id: gas_percent_bar
                  x: 1
                  y: 4
                  height: 10
                  width: 290
                  radius: 0
                  min_value: 1
                  max_value: 100
                  bg_opa: COVER
                  bg_color: !lambda return lv_color_hex(id(color_25));
                  indicator:
                    radius: 0
                    bg_color: !lambda return lv_color_hex(id(color_100)); // placeholder
                  value: !lambda |-
                    int y = id(gas_weight);
                    if( y < 0) {
                      return 0;
                    }
                    int z = id(gas_percent);
                    if (z < 0) {
                      z = 0;
                    }
                    if (z > 100) {
                      z = 100;
                    }
                    if( z <= id(settings_min_gas_value_persistent) ) {
                      lv_obj_set_style_bg_color(id(gas_percent_bar), lv_color_hex(id(color_bad)), LV_PART_INDICATOR);
                    } else {
                      lv_obj_set_style_bg_color(id(gas_percent_bar), lv_color_hex(id(color_good)), LV_PART_INDICATOR);
                    }
                    return z;
              # 2px border on every side. The first nine boxes are 2px wider
              # than the step, so neighboring borders share those pixels and
              # each vertical divider stays 2px. The boxes sit 2px below the
              # top of gas_level_obj so the warning mark shows above and below.
              - label:  # 1/10
                  x: 1
                  y: 2
                  width: 31
                  height: 14
                  bg_opa: TRANSP
                  border_width: 2
                  radius: 0
                  border_color: 0
                  text: " "
              - label:  # 2/10
                  x: 30
                  y: 2
                  width: 31
                  height: 14
                  bg_opa: TRANSP
                  border_width: 2
                  radius: 0
                  border_color: 0
                  text: " "
              - label:  # 3/10
                  x: 59
                  y: 2
                  width: 31
                  height: 14
                  bg_opa: TRANSP
                  border_width: 2
                  radius: 0
                  border_color: 0
                  text: " "
              - label:  # 4/10
                  x: 88
                  y: 2
                  width: 31
                  height: 14
                  bg_opa: TRANSP
                  border_width: 2
                  radius: 0
                  border_color: 0
                  text: " "
              - label:  # 5/10
                  x: 117
                  y: 2
                  width: 31
                  height: 14
                  bg_opa: TRANSP
                  border_width: 2
                  radius: 0
                  border_color: 0
                  text: " "
              - label:  # 6/10
                  x: 146
                  y: 2
                  width: 31
                  height: 14
                  bg_opa: TRANSP
                  border_width: 2
                  radius: 0
                  border_color: 0
                  text: " "
              - label:  # 7/10
                  x: 175
                  y: 2
                  width: 31
                  height: 14
                  bg_opa: TRANSP
                  border_width: 2
                  radius: 0
                  border_color: 0
                  text: " "
              - label:  # 8/10
                  x: 204
                  y: 2
                  width: 31
                  height: 14
                  bg_opa: TRANSP
                  border_width: 2
                  radius: 0
                  border_color: 0
                  text: " "
              - label:  # 9/10
                  x: 233
                  y: 2
                  width: 31
                  height: 14
                  bg_opa: TRANSP
                  border_width: 2
                  radius: 0
                  border_color: 0
                  text: " "
              - label:  # 10/10
                  x: 262
                  y: 2
                  width: 29
                  height: 14
                  bg_opa: TRANSP
                  border_width: 2
                  radius: 0
                  border_color: 0
                  text: " "
        # Fire icon, ghost "1888", live g/h, then Montserrat "g/h".
        # The value is right-aligned so unused leading ghost digits stay visible.
        # With no known rate, or a rate below GAS_RATE_STABLE_LIMIT, the
        # digits stay blank and "g/h" and the fire icon use color_00.
        - label:
            id: weight_rate_icon
            align: TOP_LEFT
            x: 12
            y: 147
            width: 22
            bg_color: 0x000000
            bg_opa: COVER
            pad_all: 0
            border_width: 0
            text_font: ICON_FONT_22
            text_align: LEFT
            text_color: !lambda |-
              if (!id(gas_rate_known) || id(gas_rate_g_per_h) < ${GAS_RATE_STABLE_LIMIT}) {
                return lv_color_hex(id(color_00));
              }
              return lv_color_hex(id(color_100));
            text: "\U000F0238"
        - label:
            id: weight_rate_background
            align: TOP_LEFT
            x: 23
            y: 144
            width: 80
            bg_color: 0x000000
            bg_opa: TRANSP
            pad_all: 0
            border_width: 0
            text_font: SEGMENT_FONT_24
            text_align: RIGHT
            text_color: !lambda return lv_color_hex(id(color_25));
            text: "1888"
        - label:
            id: weight_rate_value
            align: TOP_LEFT
            x: 23
            y: 144
            width: 80
            bg_opa: TRANSP
            pad_all: 0
            border_width: 0
            text_font: SEGMENT_FONT_24
            text_align: RIGHT
            text_color: !lambda return lv_color_hex(id(color_100));
            text: !lambda |-
              if (!id(gas_rate_known) || id(gas_rate_g_per_h) < ${GAS_RATE_STABLE_LIMIT}) {
                return "";
              }
              int grams = (int) (id(gas_rate_g_per_h) + 0.5f);
              if (grams < 0) {
                grams = 0;
              }
              if (grams > 1999) {
                grams = 1999;
              }
              static char buf[8];
              snprintf(buf, sizeof(buf), "%d", grams);
              return buf;
        - label:
            id: weight_rate_unit
            align: TOP_LEFT
            x: 105
            y: 151
            width: 40
            bg_color: 0x000000
            bg_opa: COVER
            pad_all: 0
            border_width: 0
            text_font: MONTSERRAT_18
            text_align: LEFT
            text_color: !lambda |-
              if (!id(gas_rate_known) || id(gas_rate_g_per_h) < ${GAS_RATE_STABLE_LIMIT}) {
                return lv_color_hex(id(color_00));
              }
              return lv_color_hex(id(color_100));
            text: "g/h"
        # Ghost "88.8", live hours on top, then "h" and the empty hourglass.
        # The decimal is zero-width, and both labels are right-aligned, so
        # "6.0" leaves the leading ghost 8 visible. Do not zero-pad.
        # The ghost stays visible. The hours stay blank until a known rate
        # is at or above GAS_RATE_STABLE_LIMIT and the remaining time is
        # known and non-negative. "h" uses color_00 while the hours are
        # blank. The hourglass follows the rate, same as the fire icon.
        - label:
            id: weight_time_background
            align: TOP_LEFT
            x: 204
            y: 144
            width: 62
            bg_color: 0x000000
            bg_opa: COVER
            pad_all: 0
            border_width: 0
            text_font: SEGMENT_FONT_24
            text_align: RIGHT
            text_color: !lambda return lv_color_hex(id(color_25));
            text: "88.8"
        - label:
            id: weight_time_value
            align: TOP_LEFT
            x: 204
            y: 144
            width: 62
            bg_opa: TRANSP
            pad_all: 0
            border_width: 0
            text_font: SEGMENT_FONT_24
            text_align: RIGHT
            text_color: !lambda return lv_color_hex(id(color_100));
            text: !lambda |-
              if (!id(gas_rate_known) || id(gas_rate_g_per_h) < ${GAS_RATE_STABLE_LIMIT} || !id(gas_time_known)) {
                return "";
              }
              float h = id(gas_time_h);
              if (!(h >= 0.0f)) {
                return "";
              }
              if (h > 99.9f) {
                h = 99.9f;
              }
              static char buf[8];
              snprintf(buf, sizeof(buf), "%.1f", (double) h);
              return buf;
        - label:
            id: weight_time_unit
            align: TOP_LEFT
            x: 268
            y: 151
            width: 16
            bg_color: 0x000000
            bg_opa: COVER
            pad_all: 0
            border_width: 0
            text_font: MONTSERRAT_18
            text_align: LEFT
            text_color: !lambda |-
              if (!id(gas_rate_known) || id(gas_rate_g_per_h) < ${GAS_RATE_STABLE_LIMIT} || !id(gas_time_known)) {
                return lv_color_hex(id(color_00));
              }
              if (!(id(gas_time_h) >= 0.0f)) {
                return lv_color_hex(id(color_00));
              }
              return lv_color_hex(id(color_100));
            text: "h"
        - label:
            id: weight_time_icon
            align: TOP_LEFT
            x: 286
            y: 147
            width: 22
            bg_color: 0x000000
            bg_opa: COVER
            pad_all: 0
            border_width: 0
            text_font: ICON_FONT_22
            text_align: LEFT
            text_color: !lambda |-
              if (!id(gas_rate_known) || id(gas_rate_g_per_h) < ${GAS_RATE_STABLE_LIMIT}) {
                return lv_color_hex(id(color_00));
              }
              return lv_color_hex(id(color_100));
            text: "\U000F06AD"

  # # # # # # # # # # # # # # # # # # # # # # # # # # # # # # # # # # # # # # # # # # # # #
    - id: calibration0_page
      skip: true
      bg_color: 0
      bg_opa: COVER
      pad_all: 0
      scrollable: false
      on_load:
        then:
          - lambda: |-
              id(scale_hold) = true;
              id(settings_scale_raw_zero) = id(settings_scale_raw_zero_persistent);
              id(settings_scale_bottle_kg) = id(settings_scale_bottle_kg_persistent);
              id(calibration2_hundredths) = id(calibration2_hundredths_persisted);
          - script.execute: scale_power_on
      widgets:
        - label:
            id: calibration0_label
            x: 14
            y: 61
            width: 292
            height: 56
            text_font: MONTSERRAT_20
            text_align: CENTER
            long_mode: WRAP
            bg_opa: TRANSP
            text_color: !lambda return lv_color_hex(id(color_100));
            text: "Remove Gas Bottle from GasBuddy"
        - button:
            id: calibration0_next_button
            x: 14
            y: 136
            width: 292
            height: 36
            pad_all: 0
            scrollable: false
            radius: 0
            bg_opa: COVER
            bg_color: !lambda return lv_color_hex(id(color_50));
            shadow_color: !lambda return lv_color_hex(id(color_25));
            widgets:
              - label:
                  id: calibration0_next_button_label
                  align: CENTER
                  width: 292
                  text_font: MONTSERRAT_20
                  text_align: CENTER
                  text_color: !lambda return lv_color_hex(id(color_100));
                  bg_color: !lambda return lv_color_hex(id(color_50));
                  text: "Continue"
            on_click:
              - lambda: |-
                  if (id(uart_gas_value) >= 0) {
                    id(settings_scale_raw_zero) = id(uart_gas_value);
                  }
              - lvgl.page.show: calibration1_page

  # # # # # # # # # # # # # # # # # # # # # # # # # # # # # # # # # # # # # # # # # # # # #
    - id: calibration1_page
      skip: true
      bg_color: 0
      bg_opa: COVER
      pad_all: 0
      scrollable: false
      on_load:
        then:
          - script.execute: show_scale_bottle_kg_selection
      widgets:
        - label:
            id: calibration1_label
            x: 14
            y: 42
            width: 292
            height: 28
            text_font: MONTSERRAT_20
            text_align: CENTER
            bg_opa: TRANSP
            text_color: !lambda return lv_color_hex(id(color_100));
            text: "Select gas fill weight"
        - button:
            id: calibration_bottle_kg_button_0
            x: 14
            y: 77
            width: 92
            height: 48
            checkable: true
            scrollable: false
            pad_all: 0
            radius: 0
            bg_opa: COVER
            bg_color: !lambda return lv_color_hex(id(color_25));
            border_width: 1
            border_color: !lambda return lv_color_hex(id(color_50));
            checked:
              bg_opa: COVER
              bg_color: !lambda return lv_color_hex(id(color_50));
              border_color: !lambda return lv_color_hex(id(color_50));
            widgets:
              - label:
                  id: calibration_bottle_kg_button_0_label
                  align: CENTER
                  width: 92
                  text_font: MONTSERRAT_20
                  text_align: CENTER
                  bg_opa: TRANSP
                  text_color: !lambda |-
                    if (id(settings_scale_bottle_kg) == id(scale_bottle_kg_options)[0]) {
                      return lv_color_hex(id(color_100));
                    }
                    return lv_color_hex(id(color_75));
                  text: !lambda |-
                    static char buf[16];
                    snprintf(buf, sizeof(buf), "%d kg", id(scale_bottle_kg_options)[0]);
                    return buf;
            on_click:
              - lambda: id(settings_scale_bottle_kg) = id(scale_bottle_kg_options)[0];
              - script.execute: show_scale_bottle_kg_selection
        - button:
            id: calibration_bottle_kg_button_1
            x: 114
            y: 77
            width: 92
            height: 48
            checkable: true
            scrollable: false
            pad_all: 0
            radius: 0
            bg_opa: COVER
            bg_color: !lambda return lv_color_hex(id(color_25));
            border_width: 1
            border_color: !lambda return lv_color_hex(id(color_50));
            checked:
              bg_opa: COVER
              bg_color: !lambda return lv_color_hex(id(color_50));
              border_color: !lambda return lv_color_hex(id(color_50));
            widgets:
              - label:
                  id: calibration_bottle_kg_button_1_label
                  align: CENTER
                  width: 92
                  text_font: MONTSERRAT_20
                  text_align: CENTER
                  bg_opa: TRANSP
                  text_color: !lambda |-
                    if (id(settings_scale_bottle_kg) == id(scale_bottle_kg_options)[1]) {
                      return lv_color_hex(id(color_100));
                    }
                    return lv_color_hex(id(color_75));
                  text: !lambda |-
                    static char buf[16];
                    snprintf(buf, sizeof(buf), "%d kg", id(scale_bottle_kg_options)[1]);
                    return buf;
            on_click:
              - lambda: id(settings_scale_bottle_kg) = id(scale_bottle_kg_options)[1];
              - script.execute: show_scale_bottle_kg_selection
        - button:
            id: calibration_bottle_kg_button_2
            x: 214
            y: 77
            width: 92
            height: 48
            checkable: true
            scrollable: false
            pad_all: 0
            radius: 0
            bg_opa: COVER
            bg_color: !lambda return lv_color_hex(id(color_25));
            border_width: 1
            border_color: !lambda return lv_color_hex(id(color_50));
            checked:
              bg_opa: COVER
              bg_color: !lambda return lv_color_hex(id(color_50));
              border_color: !lambda return lv_color_hex(id(color_50));
            widgets:
              - label:
                  id: calibration_bottle_kg_button_2_label
                  align: CENTER
                  width: 92
                  text_font: MONTSERRAT_20
                  text_align: CENTER
                  bg_opa: TRANSP
                  text_color: !lambda |-
                    if (id(settings_scale_bottle_kg) == id(scale_bottle_kg_options)[2]) {
                      return lv_color_hex(id(color_100));
                    }
                    return lv_color_hex(id(color_75));
                  text: !lambda |-
                    static char buf[16];
                    snprintf(buf, sizeof(buf), "%d kg", id(scale_bottle_kg_options)[2]);
                    return buf;
            on_click:
              - lambda: id(settings_scale_bottle_kg) = id(scale_bottle_kg_options)[2];
              - script.execute: show_scale_bottle_kg_selection
        - button:
            id: calibration1_next_button
            x: 14
            y: 136
            width: 292
            height: 36
            pad_all: 0
            scrollable: false
            radius: 0
            bg_opa: COVER
            bg_color: !lambda return lv_color_hex(id(color_50));
            shadow_color: !lambda return lv_color_hex(id(color_25));
            widgets:
              - label:
                  id: calibration1_next_button_label
                  align: CENTER
                  width: 292
                  text_font: MONTSERRAT_20
                  text_align: CENTER
                  text_color: !lambda return lv_color_hex(id(color_100));
                  bg_color: !lambda return lv_color_hex(id(color_50));
                  text: "Continue"
            on_click:
              - lvgl.page.show: calibration2_page

  # # # # # # # # # # # # # # # # # # # # # # # # # # # # # # # # # # # # # # # # # # # # #
    - id: calibration2_page
      skip: true
      bg_color: 0
      bg_opa: COVER
      pad_all: 0
      scrollable: false
      on_load:
        then:
          - lambda: |-
              const int lo = ${CALIBRATION2_MIN_HUNDREDTHS};
              const int hi = ${CALIBRATION2_MAX_HUNDREDTHS};
              const int step = ${CALIBRATION2_STEP_HUNDREDTHS};
              int v = id(calibration2_hundredths);
              if (v < lo) v = lo;
              if (v > hi) v = hi;
              v = ((v - lo + step / 2) / step) * step + lo;
              if (v > hi) v = hi;
              id(calibration2_hundredths) = v;
              lv_slider_set_value(calibration2_slider, v, LV_ANIM_OFF);
          - lvgl.label.update:
              id: calibration2_label
              text: !lambda |-
                static char buf[12];
                snprintf(buf, sizeof(buf), "%d g", id(calibration2_hundredths) * 10);
                return buf;
      widgets:
        - label:
            id: calibration2_label
            x: 14
            y: 32
            width: 220
            height: 28
            text_font: MONTSERRAT_20
            text_align: CENTER
            bg_opa: TRANSP
            text_color: !lambda return lv_color_hex(id(color_100));
            text: " "
        - button:
            id: calibration2_inc_button
            x: 244
            y: 40
            width: 62
            height: 44
            pad_all: 0
            scrollable: false
            radius: 0
            bg_opa: COVER
            bg_color: !lambda return lv_color_hex(id(color_50));
            shadow_color: !lambda return lv_color_hex(id(color_25));
            widgets:
              - label:
                  id: calibration2_inc_button_label
                  align: CENTER
                  text_font: ICON_FONT_30
                  text_color: !lambda return lv_color_hex(id(color_100));
                  bg_color: !lambda return lv_color_hex(id(color_50));
                  text: "\U000F0415"
            on_click:
              - lambda: |-
                  const int step = ${CALIBRATION2_STEP_HUNDREDTHS};
                  const int hi = ${CALIBRATION2_MAX_HUNDREDTHS};
                  int next = id(calibration2_hundredths) + step;
                  if (next > hi) next = hi;
                  id(calibration2_hundredths) = next;
              - lvgl.slider.update:
                  id: calibration2_slider
                  animated: false
                  value: !lambda return id(calibration2_hundredths);
              - lvgl.label.update:
                  id: calibration2_label
                  text: !lambda |-
                    static char buf[12];
                    snprintf(buf, sizeof(buf), "%d g", id(calibration2_hundredths) * 10);
                    return buf;
        - button:
            id: calibration2_dec_button
            x: 244
            y: 88
            width: 62
            height: 44
            pad_all: 0
            scrollable: false
            radius: 0
            bg_opa: COVER
            bg_color: !lambda return lv_color_hex(id(color_50));
            shadow_color: !lambda return lv_color_hex(id(color_25));
            widgets:
              - label:
                  id: calibration2_dec_button_label
                  align: CENTER
                  text_font: ICON_FONT_30
                  text_color: !lambda return lv_color_hex(id(color_100));
                  bg_color: !lambda return lv_color_hex(id(color_50));
                  text: "\U000F0374"
            on_click:
              - lambda: |-
                  const int step = ${CALIBRATION2_STEP_HUNDREDTHS};
                  const int lo = ${CALIBRATION2_MIN_HUNDREDTHS};
                  int next = id(calibration2_hundredths) - step;
                  if (next < lo) next = lo;
                  id(calibration2_hundredths) = next;
              - lvgl.slider.update:
                  id: calibration2_slider
                  animated: false
                  value: !lambda return id(calibration2_hundredths);
              - lvgl.label.update:
                  id: calibration2_label
                  text: !lambda |-
                    static char buf[12];
                    snprintf(buf, sizeof(buf), "%d g", id(calibration2_hundredths) * 10);
                    return buf;
        - slider:
            id: calibration2_slider
            x: 14
            y: 72
            width: 220
            height: 15
            min_value: ${CALIBRATION2_MIN_HUNDREDTHS}
            max_value: ${CALIBRATION2_MAX_HUNDREDTHS}
            value: 1000
            bg_color: !lambda return lv_color_hex(id(color_25));
            indicator:
              bg_color: !lambda return lv_color_hex(id(color_50));
            knob:
              bg_color: !lambda return lv_color_hex(id(color_100));
            on_value:
              - lambda: |-
                  const int lo = ${CALIBRATION2_MIN_HUNDREDTHS};
                  const int hi = ${CALIBRATION2_MAX_HUNDREDTHS};
                  const int step = ${CALIBRATION2_STEP_HUNDREDTHS};
                  // x is float. Integer division is required: float division
                  // turns a 50 g step into +20 g and each event walks further.
                  int v = (int) x;
                  if (v < lo) v = lo;
                  if (v > hi) v = hi;
                  int snapped = ((v - lo + step / 2) / step) * step + lo;
                  if (snapped < lo) snapped = lo;
                  if (snapped > hi) snapped = hi;
                  id(calibration2_hundredths) = snapped;
                  if (snapped != v) {
                    lv_slider_set_value(calibration2_slider, snapped, LV_ANIM_OFF);
                  }
              - lvgl.label.update:
                  id: calibration2_label
                  text: !lambda |-
                    static char buf[12];
                    snprintf(buf, sizeof(buf), "%d g", id(calibration2_hundredths) * 10);
                    return buf;
        - label:
            id: calibration2_tare_label
            x: 14
            y: 96
            width: 220
            height: 28
            text_font: MONTSERRAT_20
            text_align: CENTER
            bg_opa: TRANSP
            pad_all: 0
            border_width: 0
            text_color: !lambda return lv_color_hex(id(color_100));
            text: "Gas bottle tare"
        - button:
            id: calibration2_ok_button
            x: 14
            y: 136
            width: 292
            height: 36
            pad_all: 0
            scrollable: false
            radius: 0
            bg_opa: COVER
            bg_color: !lambda return lv_color_hex(id(color_50));
            shadow_color: !lambda return lv_color_hex(id(color_25));
            widgets:
              - label:
                  id: calibration2_ok_button_label
                  align: CENTER
                  width: 292
                  text_font: MONTSERRAT_20
                  text_align: CENTER
                  text_color: !lambda return lv_color_hex(id(color_100));
                  bg_color: !lambda return lv_color_hex(id(color_50));
                  text: "Continue"
            on_click:
              - lvgl.page.show: calibration3_page

  # # # # # # # # # # # # # # # # # # # # # # # # # # # # # # # # # # # # # # # # # # # # #
    - id: calibration3_page
      skip: true
      bg_color: 0
      bg_opa: COVER
      pad_all: 0
      scrollable: false
      widgets:
        - label:
            id: calibration3_label
            x: 14
            y: 61
            width: 292
            height: 56
            text_font: MONTSERRAT_20
            text_align: CENTER
            long_mode: WRAP
            bg_opa: TRANSP
            text_color: !lambda return lv_color_hex(id(color_100));
            text: "Place new bottle on the GasBuddy"
        - button:
            id: calibration3_abort_button
            x: 14
            y: 136
            width: 142
            height: 36
            pad_all: 0
            scrollable: false
            radius: 0
            bg_opa: COVER
            bg_color: !lambda return lv_color_hex(id(color_50));
            shadow_color: !lambda return lv_color_hex(id(color_25));
            widgets:
              - label:
                  id: calibration3_abort_button_label
                  align: CENTER
                  width: 142
                  text_font: MONTSERRAT_20
                  text_align: CENTER
                  text_color: !lambda return lv_color_hex(id(color_100));
                  bg_color: !lambda return lv_color_hex(id(color_50));
                  text: "Abort"
            on_click:
              - lvgl.page.show: scale_page
        - button:
            id: calibration3_ok_button
            x: 164
            y: 136
            width: 142
            height: 36
            pad_all: 0
            scrollable: false
            radius: 0
            bg_opa: COVER
            bg_color: !lambda return lv_color_hex(id(color_50));
            shadow_color: !lambda return lv_color_hex(id(color_25));
            widgets:
              - label:
                  id: calibration3_ok_button_label
                  align: CENTER
                  width: 142
                  text_font: MONTSERRAT_20
                  text_align: CENTER
                  text_color: !lambda return lv_color_hex(id(color_100));
                  bg_color: !lambda return lv_color_hex(id(color_50));
                  text: "Done"
            on_click:
              - script.execute: reset_gas_consumption
              - lvgl.page.show: calibration4_page

  # # # # # # # # # # # # # # # # # # # # # # # # # # # # # # # # # # # # # # # # # # # # #
    - id: calibration4_page
      skip: true
      bg_color: 0
      bg_opa: COVER
      pad_all: 0
      scrollable: false
      on_load:
        then:
          - lambda: |-
              if (id(uart_gas_value) >= 0) {
                id(settings_scale_raw_zero_persistent) = id(settings_scale_raw_zero);
                id(settings_scale_bottle_kg_persistent) = id(settings_scale_bottle_kg);
                id(calibration2_hundredths_persisted) = id(calibration2_hundredths);
                id(settings_scale_brutto_persistent) = id(uart_gas_value);
                ESP_LOGI("uart_gasbuddy", "Calibration saved: zero %d brutto %d bottle %d kg empty %d hundredths", id(settings_scale_raw_zero_persistent), id(settings_scale_brutto_persistent), id(settings_scale_bottle_kg_persistent), id(calibration2_hundredths_persisted));
              } else {
                ESP_LOGW("uart_gasbuddy", "Calibration not saved: no raw reading, so the gram label stays ---");
              }
      widgets:
        - label:
            id: calibration4_label
            x: 14
            y: 32
            width: 292
            height: 100
            text_font: MONTSERRAT_20
            text_align: CENTER
            long_mode: WRAP
            bg_opa: TRANSP
            text_color: !lambda return lv_color_hex(id(color_100));
            text: "Persisting the settings may\ntake up to 60 seconds!\nSo wait a bit before powering off the device."
        - button:
            id: calibration4_understood_button
            x: 14
            y: 136
            width: 292
            height: 36
            pad_all: 0
            scrollable: false
            radius: 0
            bg_opa: COVER
            bg_color: !lambda return lv_color_hex(id(color_50));
            shadow_color: !lambda return lv_color_hex(id(color_25));
            on_click:
              - lvgl.page.show: scale_page
            widgets:
              - label:
                  id: calibration4_understood_button_label
                  align: CENTER
                  width: 292
                  text_font: MONTSERRAT_20
                  text_align: CENTER
                  text_color: !lambda return lv_color_hex(id(color_100));
                  bg_color: !lambda return lv_color_hex(id(color_50));
                  text: "Understood"

  # # # # # # # # # # # # # # # # # # # # # # # # # # # # # # # # # # # # # # # # # # # # #
    - id: settings_page
      skip: true
      pad_all: 0
      widgets:
        - obj:
            x: 0
            y: 30
            width: 320
            height: 142
            bg_color: 0
            bg_opa: COVER
            pad_all: 0
            border_width: 0
            radius: 0
            widgets:
              - label:
                  id: current_wifi_ip_label1
                  x: 0
                  y: 0
                  width: 160
                  text_align: LEFT
                  text_color: !lambda return lv_color_hex(id(color_100));
                  text_font: MONTSERRAT_18
                  text: "IP Address"
              - label:
                  id: current_wifi_ip_label
                  x: 170
                  y: 0
                  width: 146
                  text_align: LEFT
                  text_color: !lambda return lv_color_hex(id(color_100));
                  text_font: MONTSERRAT_18
                  text: !lambda |-
                    return id(current_ip_address).c_str();
              - label:
                  id: current_version_label1
                  x: 0
                  y: 21
                  width: 160
                  text_align: LEFT
                  text_color: !lambda return lv_color_hex(id(color_100));
                  text_font: MONTSERRAT_18
                  text: "Current version"
              - label:
                  id: current_version_label2
                  x: 170
                  y: 21
                  width: 146
                  text_align: LEFT
                  text_color: !lambda return lv_color_hex(id(color_100));
                  text_font: MONTSERRAT_18
                  text: ${version}
              - label:
                  id: uart_raw_value1
                  x: 0
                  y: 42
                  width: 160
                  text_align: LEFT
                  text_color: !lambda return lv_color_hex(id(color_100));
                  text_font: MONTSERRAT_18
                  text: "GasBuddy raw"
              - label:
                  id: uart_raw_value
                  x: 170
                  y: 42
                  width: 146
                  text_font: MONTSERRAT_18
                  text_color: !lambda return lv_color_hex(id(color_100));
                  text_align: LEFT
                  text: !lambda |-
                    int v = id(uart_gas_value);
                    if (v < 0) {
                      return "no data";
                    }
                    return to_string(v).c_str();
              - label:
                  id: soc_warning_label1
                  x: 0
                  y: 63
                  width: 160
                  text_align: LEFT
                  text_color: !lambda return lv_color_hex(id(color_100));
                  text_font: MONTSERRAT_18
                  text: "Warning SOC"
              - label:
                  id: soc_warning_label2
                  x: 170
                  y: 63
                  width: 146
                  text_align: LEFT
                  text_color: !lambda return lv_color_hex(id(color_100));
                  text_font: MONTSERRAT_18
                  text: !lambda |-
                    int v = id(min_soc_value_number).state;
                    return (to_string(v) + " %").c_str();
              - label:
                  id: gas_warning_label1
                  x: 0
                  y: 86
                  width: 160
                  text_align: LEFT
                  text_color: !lambda return lv_color_hex(id(color_100));
                  text_font: MONTSERRAT_18
                  text: "Warning Gas"
              - label:
                  id: gas_warning_label2
                  x: 170
                  y: 86
                  width: 146
                  text_align: LEFT
                  text_color: !lambda return lv_color_hex(id(color_100));
                  text_font: MONTSERRAT_18
                  text: !lambda |-
                    int v = id(min_gas_value_number).state;
                    return (to_string(v) + " %").c_str();
              - label:
                  id: color_100_label
                  x: 0
                  y: 122
                  width: 40
                  height: 20
                  bg_color: !lambda return lv_color_hex(id(color_100));
                  text: " "
              - label:
                  id: color_75_label
                  x: 40
                  y: 122
                  width: 40
                  height: 20
                  bg_color: !lambda return lv_color_hex(id(color_75));
                  text: " "
              - label:
                  id: color_50_label
                  x: 80
                  y: 122
                  width: 40
                  height: 20
                  bg_color: !lambda return lv_color_hex(id(color_50));
                  text: " "
              - label:
                  id: color_25_label
                  x: 120
                  y: 122
                  width: 40
                  height: 20
                  bg_color: !lambda return lv_color_hex(id(color_25));
                  text: " "
              - label:
                  id: color_00_label
                  x: 160
                  y: 122
                  width: 40
                  height: 20
                  bg_color: !lambda return lv_color_hex(id(color_00));
                  text: " "
              - label:
                  id: color_good_label
                  x: 200
                  y: 122
                  width: 40
                  height: 20
                  bg_color: !lambda return lv_color_hex(id(color_good));
                  text: " "
              - label:
                  id: color_bad_label
                  x: 240
                  y: 122
                  width: 40
                  height: 20
                  bg_color: !lambda return lv_color_hex(id(color_bad));
                  text: " "
              - label:
                  id: color_light_label
                  x: 280
                  y: 122
                  width: 40
                  height: 20
                  bg_color: !lambda return lv_color_hex(id(color_light));
                  text: " "
              - label:
                  x: 0
                  y: 0
                  bg_opa: TRANSP
                  width: 320
                  height: 142
                  text: " "
                  clickable: True
                  on_press:
                    - script.execute: toggle_settings_page
              - button:
                  id: calibration_button
                  x: 253
                  y: 46
                  width: 67
                  height: 66
                  pad_all: 0
                  scrollable: false
                  radius: 0
                  bg_opa: COVER
                  bg_color: !lambda return lv_color_hex(id(color_50));
                  shadow_color: !lambda return lv_color_hex(id(color_25));
                  widgets:
                    - label:
                        id: calibration_button_label
                        align: CENTER
                        text_font: ICON_FONT_39
                        text_align: CENTER
                        text_color: !lambda return lv_color_hex(id(color_100));
                        bg_color: !lambda return lv_color_hex(id(color_50));
                        text: "\U000F1358"
                    - label:
                        id: calibration_button_cog_label
                        align: CENTER
                        x: 17
                        y: 17
                        width: 30
                        height: 30
                        clickable: false
                        text_font: ICON_FONT_27
                        text_align: CENTER
                        long_mode: CLIP
                        bg_opa: TRANSP
                        text_color: !lambda return lv_color_hex(id(color_100));
                        text: "\U000F0493"
                  on_click:
                    - lvgl.page.show: calibration0_page


sensor:
  - platform: adc
    pin: GPIO0
    name: "Battery SOC"
    unit_of_measurement: "%"
    state_class: measurement
    device_class: battery
    accuracy_decimals: 0
    attenuation: 12db
    samples: 16                # samples taken per update interval
    filters:
      - multiply: 3.0          # due to external voltage divider on adc input
      - sliding_window_moving_average:
          window_size: 15      # average over 15 values
      - calibrate_linear:      # linearise voltage->SOC dependency
          method: exact
          datapoints:
            - 3.00 ->   0.0    # <=3.00V = battery empty (0.0%)
            - 3.36 ->   5.0
            - 3.41 ->  10.0
            - 3.48 ->  20.0
            - 3.52 ->  30.0
            - 3.56 ->  40.0
            - 3.61 ->  50.0
            - 3.70 ->  60.0
            - 3.79 ->  70.0
            - 3.89 ->  80.0
            - 4.00 ->  90.0
            - 4.05 -> 100.0    # >=4.05V = battery full (100.0%)
      - clamp:
          min_value: 0.0
          max_value: 100.0
    update_interval: 4s        # new value after 4s*15(=window size) = 60s!
    on_value:
      - lambda: |-
          id(battery_soc_value) = x;
          id(battery_soc_seen) = true;
      - lvgl.widget.refresh: battery_symbol

  - platform: wifi_signal
    name: "WiFi Signal Strength ESP32"
    update_interval: 10s
  - platform: internal_temperature
    name: "CPU Temperature ESP32"
    update_interval: 10s
    device_class: temperature
    state_class: measurement
    unit_of_measurement: "°C"
    accuracy_decimals: 1

  - platform: template
    name: "Gasbuddy level in g"
    id: gasbuddy_gas_weight
    device_class: weight
    state_class: measurement
    unit_of_measurement: g
    accuracy_decimals: 0
    icon: "mdi:weight-gram"
    on_value:
      - globals.set:
          id: gas_weight
          value: !lambda |-
            if (x >= 11000) {
              return 11000;
            }
            return int(x);
      - lvgl.widget.refresh: [uart_raw_value, weight_label]

  - platform: template
    name: "Gasbuddy level in %"
    id: gasbuddy_gas_percent
    state_class: measurement
    unit_of_measurement: "%"
    icon: "mdi:gas-cylinder"
    update_interval: never
    lambda: |-
      return id(gas_percent);
    on_value:
      - globals.set:
          id: gas_percent
          value: !lambda |-
            int percent = int(x);
            if (percent < 0) {
              return 0;
            }
            if (percent > 100) {
              return 100;
            }
            return percent;
      - lambda: id(gas_percent_seen) = true;
      - lvgl.widget.refresh: [gas_percent_bar, uart_raw_value, warning_on_label]

  - platform: template
    name: "Gasbuddy consumption"
    id: gasbuddy_gas_consumption
    state_class: measurement
    unit_of_measurement: "g/h"
    accuracy_decimals: 1
    icon: "mdi:fire"
    update_interval: never

  - platform: template
    name: "Gasbuddy time left"
    id: gasbuddy_time_left
    device_class: duration
    state_class: measurement
    unit_of_measurement: h
    accuracy_decimals: 1
    icon: "mdi:timer-outline"
    update_interval: never

binary_sensor:
  - platform: status
    name: "Status ESP"

script:
  # Off-to-on edge of the scale rail. A rail that is already up does not
  # restart the settle wait.
  - id: scale_power_on
    then:
      - if:
          condition:
            lambda: 'return !${DEMO_MODE};'
          then:
            - lambda: |-
                if (!id(scale_rail_on)) {
                  id(scale_powered_at) = millis();
                }
                id(scale_rail_on) = true;
            - output.turn_on: scale_power

  # Drops the rail only while the backlight is off and the wizard is closed.
  - id: scale_power_off_if_idle
    then:
      - if:
          condition:
            lambda: 'return !${DEMO_MODE} && !id(backlight_on) && !id(scale_hold);'
          then:
            - lambda: |-
                if (id(scale_rail_on)) {
                  ESP_LOGI("uart_gasbuddy", "Scale rail off");
                }
                id(scale_rail_on) = false;
            - output.turn_off: scale_power

  # One UART poll, then grams and g/h. Turns the rail off afterwards when
  # the backlight is off. mode single so the 5 s and 2 min callers cannot
  # overlap on the bus.
  - id: poll_gas_scale
    mode: single
    then:
      - lambda: |-
          uint8_t discard;
          while (id(uart_gasbuddy).available()) {
            id(uart_gasbuddy).read_byte(&discard);
          }
      - uart.write:
          id: uart_gasbuddy
          data: [0xAA, 0x14, 0xC3, 0x3C]
      - delay: 100ms
      - lambda: |-
          if (id(uart_gasbuddy).available() < 4) {
            ESP_LOGE("uart_gasbuddy", "No Data");
            return;
          }
          uint8_t buf[64];
          int got = 0;
          while (id(uart_gasbuddy).available() && got < (int) sizeof(buf)) {
            id(uart_gasbuddy).read_byte(&buf[got++]);
          }
          if (got < 4) {
            ESP_LOGE("uart_gasbuddy", "No weight: short reply (%d bytes), raw count unchanged", got);
            return;
          }
          // reply[2:3], big-endian. Kept on the device only.
          const uint16_t value = (uint16_t(buf[2]) << 8) | buf[3];
          id(uart_gas_value) = value;
          ESP_LOGI("uart_gasbuddy", "Parsed value: %u", value);
      - lvgl.widget.refresh: uart_raw_value
      - script.execute: update_remaining_gas
      - script.execute: scale_power_off_if_idle

  # Remaining gas from the last saved calibration. UART readings are raw
  # counts, not grams. Zero is the empty platform, brutto is the full bottle.
  # The known empty-bottle and fill masses only mark where 0% sits in that span.
  - id: update_remaining_gas
    then:
      - lambda: |-
          if (!${DEMO_MODE} && id(uart_gas_value) < 0) {
            ESP_LOGI("uart_gasbuddy", "No weight: no raw reading yet, label stays ---");
            return;
          }
          int64_t zero = id(settings_scale_raw_zero_persistent);
          int64_t brutto = id(settings_scale_brutto_persistent);
          int64_t raw = id(uart_gas_value);
          int64_t empty_h = id(calibration2_hundredths_persisted);
          int64_t fill_h = (int64_t) id(settings_scale_bottle_kg_persistent) * 100;
          // Exact remaining grams while DEMO_MODE is on. The usage slope and
          // the gram readout both follow this. The percent bar still steps
          // in whole percents.
          double demo_g = 0;
          if (${DEMO_MODE}) {
            // Same formula as below. Only the inputs are synthetic: a saved
            // calibration is used when it has a span, otherwise a stand-in
            // span. Remaining gas starts at 90% and only decreases.
            if (empty_h <= 0) {
              empty_h = 1000;
            }
            if (fill_h <= 0) {
              fill_h = 1100;
            }
            if (brutto <= zero) {
              zero = 10000;
              brutto = 30000;
            }
            const int64_t full_h_demo = empty_h + fill_h;
            const int64_t span_demo = brutto - zero;
            const int64_t empty_count_demo = zero + span_demo * empty_h / full_h_demo;
            const int64_t gas_span_demo = brutto - empty_count_demo;
            const double fill_g = (double) fill_h * 10.0;
            // Piecewise random burn. A new rate is drawn every 30–75 s from
            // 0 .. 4× DEMO_GRAMS_PER_HOUR, and each poll nudges it. The g/h
            // estimate is a ~30 s slope, so the hold is long enough for that
            // label to settle and then move again.
            static double demo_grams = -1.0;
            static double demo_rate_g_h = 0.0;
            static uint32_t demo_last_ms = 0;
            static uint32_t demo_hold_until = 0;
            static uint32_t demo_rng = 0;
            const uint32_t now_ms = millis();
            const double rate_max = (double) ${DEMO_GRAMS_PER_HOUR} * 4.0;
            if (demo_grams < 0.0 || demo_rng == 0) {
              demo_rng = now_ms | 1u;
              demo_grams = fill_g * 0.90;
              demo_last_ms = now_ms;
              demo_hold_until = now_ms;
            }
            const uint32_t dt_ms = now_ms - demo_last_ms;
            demo_last_ms = now_ms;
            demo_grams -= demo_rate_g_h * ((double) dt_ms / 3600000.0);
            if ((int32_t) (now_ms - demo_hold_until) >= 0) {
              demo_rng = demo_rng * 1664525u + 1013904223u;
              demo_rate_g_h = rate_max * (double) (demo_rng % 1000u) / 999.0;
              demo_rng = demo_rng * 1664525u + 1013904223u;
              const uint32_t hold_ms = 30000u + (demo_rng % 45000u);
              demo_hold_until = now_ms + hold_ms;
              ESP_LOGI("uart_gasbuddy", "Demo consumption %.0f g/h for %u s", demo_rate_g_h, (unsigned) (hold_ms / 1000u));
            } else {
              demo_rng = demo_rng * 1664525u + 1013904223u;
              demo_rate_g_h += (double) ((int) (demo_rng % 401u) - 200);
              if (demo_rate_g_h < 0.0) {
                demo_rate_g_h = 0.0;
              }
              if (demo_rate_g_h > rate_max) {
                demo_rate_g_h = rate_max;
              }
            }
            if (demo_grams < 0.0) {
              demo_grams = fill_g * 0.90;
            }
            if (demo_grams > fill_g) {
              demo_grams = fill_g;
            }
            demo_g = demo_grams;
            const double demo_percent = (fill_g > 0.0) ? (demo_g * 100.0 / fill_g) : 0.0;
            if (gas_span_demo > 0) {
              raw = empty_count_demo + (int64_t) (gas_span_demo * demo_percent / 100.0 + 0.5);
            }
          }
          const int64_t span = brutto - zero;
          const int64_t full_h = empty_h + fill_h;
          const char *skip = nullptr;
          if (span <= 0) {
            skip = "saved brutto is not above saved zero";
          } else if (fill_h <= 0) {
            skip = "bottle fill weight is 0";
          } else if (full_h <= 0) {
            skip = "empty bottle plus fill is 0";
          }
          if (skip != nullptr) {
            ESP_LOGI("uart_gasbuddy", "No weight: %s (raw %d zero %d brutto %d empty %d hundredths fill %d hundredths). Label stays ---", skip, (int) raw, (int) zero, (int) brutto, (int) empty_h, (int) fill_h);
            id(gas_time_known) = false;
            id(gasbuddy_time_left).publish_state(NAN);
            return;
          }
          const int64_t empty_count = zero + span * empty_h / full_h;
          const int64_t gas_span = brutto - empty_count;
          if (gas_span <= 0) {
            ESP_LOGI("uart_gasbuddy", "No weight: empty-bottle count is not below the full-bottle count (raw %d zero %d brutto %d empty-count %d empty %d hundredths fill %d hundredths). Label stays ---", (int) raw, (int) zero, (int) brutto, (int) empty_count, (int) empty_h, (int) fill_h);
            id(gas_time_known) = false;
            id(gasbuddy_time_left).publish_state(NAN);
            return;
          }
          int64_t gas_count = raw - empty_count;
          if (gas_count < 0) {
            gas_count = 0;
          }
          if (gas_count > gas_span) {
            gas_count = gas_span;
          }
          int percent = (int) (gas_count * 100 / gas_span);
          if (percent < 0) {
            percent = 0;
          }
          if (percent > 100) {
            percent = 100;
          }
          int gas_g = (int) (fill_h * 10 * percent / 100);
          // Whole percents stay on the label. The slope uses fractional
          // grams, because a sample every 2 minutes rarely crosses a percent.
          const double exact_g = (double) fill_h * 10.0 * (double) gas_count / (double) gas_span;
          if (${DEMO_MODE}) {
            gas_g = (int) (demo_g + 0.5);
            if (gas_g < 0) {
              gas_g = 0;
            }
          }
          ESP_LOGI("uart_gasbuddy", "Calculated: %d %% (%d g) raw %d zero %d brutto %d empty-count %d%s", percent, gas_g, (int) raw, (int) zero, (int) brutto, (int) empty_count, ${DEMO_MODE} ? " demo" : "");
          id(gasbuddy_gas_weight).publish_state(gas_g);
          id(gasbuddy_gas_percent).publish_state(percent);

          // g/h from a least-squares slope over the last GAS_RATE_SAMPLES
          // remaining-gas readings. Positive means the bottle is getting lighter.
          constexpr int kRateN = ${GAS_RATE_SAMPLES};
          static double hist_g[kRateN];
          static uint32_t hist_ms[kRateN];
          static int hist_count = 0;
          static int hist_next = 0;
          static int hist_epoch = 0;
          if (id(gas_rate_epoch) != hist_epoch) {
            hist_count = 0;
            hist_next = 0;
            hist_epoch = id(gas_rate_epoch);
          }
          if (kRateN >= 2) {
            const uint32_t now_ms = millis();
            const double sample_g = ${DEMO_MODE} ? demo_g : exact_g;
            hist_g[hist_next] = sample_g;
            hist_ms[hist_next] = now_ms;
            hist_next = (hist_next + 1) % kRateN;
            if (hist_count < kRateN) {
              hist_count++;
            }
            if (hist_count < kRateN) {
              ESP_LOGI("uart_gasbuddy", "Consumption: waiting %d/%d", hist_count, kRateN);
            } else {
              const int oldest = hist_next;
              const uint32_t t0 = hist_ms[oldest];
              double sum_t = 0;
              double sum_g = 0;
              for (int i = 0; i < kRateN; i++) {
                const int idx = (oldest + i) % kRateN;
                sum_t += (double) (hist_ms[idx] - t0);
                sum_g += (double) hist_g[idx];
              }
              const double mean_t = sum_t / kRateN;
              const double mean_g = sum_g / kRateN;
              double num = 0;
              double den = 0;
              for (int i = 0; i < kRateN; i++) {
                const int idx = (oldest + i) % kRateN;
                const double dt = (double) (hist_ms[idx] - t0) - mean_t;
                const double dg = (double) hist_g[idx] - mean_g;
                num += dt * dg;
                den += dt * dt;
              }
              if (den > 0) {
                double g_per_h = -(num / den) * 3600000.0;
                if (g_per_h < 0 || !std::isfinite(g_per_h)) {
                  g_per_h = 0;
                }
                ESP_LOGI("uart_gasbuddy", "Consumption: %.1f g/h over %d readings", g_per_h, kRateN);
                id(gas_rate_g_per_h) = g_per_h;
                id(gas_rate_known) = true;
                id(gasbuddy_gas_consumption).publish_state(g_per_h);
                const double remain_g = ${DEMO_MODE} ? demo_g : exact_g;
                if (!(g_per_h >= ${GAS_RATE_STABLE_LIMIT}) || !(remain_g >= 0) || !std::isfinite(remain_g)) {
                  id(gas_time_known) = false;
                  id(gasbuddy_time_left).publish_state(NAN);
                } else {
                  float hours = (float) (remain_g / g_per_h);
                  if (!(hours >= 0.0f) || !std::isfinite(hours)) {
                    id(gas_time_known) = false;
                    id(gasbuddy_time_left).publish_state(NAN);
                  } else {
                    if (hours > 99.9f) {
                      hours = 99.9f;
                    }
                    id(gas_time_h) = hours;
                    id(gas_time_known) = true;
                    id(gasbuddy_time_left).publish_state(hours);
                  }
                }
              } else {
                id(gas_time_known) = false;
                id(gasbuddy_time_left).publish_state(NAN);
              }
            }
          }
      - lvgl.widget.refresh:
          - weight_rate_icon
          - weight_rate_background
          - weight_rate_value
          - weight_rate_unit
          - weight_time_background
          - weight_time_value
          - weight_time_unit
          - weight_time_icon

  - id: reset_gas_consumption
    then:
      - lambda: |-
          id(gas_rate_epoch)++;
          id(gas_rate_known) = false;
          id(gas_time_known) = false;
          id(gasbuddy_gas_consumption).publish_state(NAN);
          id(gasbuddy_time_left).publish_state(NAN);
          ESP_LOGI("uart_gasbuddy", "Consumption: reset");
      - lvgl.widget.refresh:
          - weight_rate_icon
          - weight_rate_background
          - weight_rate_value
          - weight_rate_unit
          - weight_time_background
          - weight_time_value
          - weight_time_unit
          - weight_time_icon

  - id: hide_boot_screen
    then:
      - if:
          condition:
            lambda: 'return !id(boot_screen_hidden);'
          then:
            - lambda: |-
                id(apply_color_scheme).execute();
            - lvgl.widget.hide: boot_screen
            - lvgl.widget.show: [status_bar_top]
            - lambda: |-
                int idx = id(settings_color_scheme_idx_persistent);
                std::string name = "white";
                for (const auto& pair : id(color_schemes)) {
                  if (static_cast<int>(pair.second[0]) == idx) {
                    name = pair.first;
                    break;
                  }
                }
                id(color_scheme_select).publish_state(name);

            # some things to refresh from persisted settings
            - lvgl.widget.refresh: battery_symbol_obj

            - if:
                condition:
                  lambda: return id(settings_hide_soc_persistent);
                then:
                  - switch.turn_on: hide_soc_switch
                else:
                  - switch.turn_off: hide_soc_switch
            - lambda: id(min_soc_value_number).publish_state(static_cast<float>(id(settings_min_soc_value_persistent)));
            - lambda: id(min_gas_value_number).publish_state(static_cast<float>(id(settings_min_gas_value_persistent)));
            - globals.set:
                id: boot_screen_hidden
                value: 'true'

  - id: apply_color_scheme
    mode: restart
    then:
      - lambda: |-
          int target_idx = id(settings_color_scheme_idx_persistent);   // current selected index (0,1,2,3)
          const std::vector<uint32_t>* selected_vec = nullptr;
          std::string selected_name = "unknown";

          // First: find the matching scheme by index (vec[0])
          for (const auto& pair : id(color_schemes)) {
            const auto& vec = pair.second;
            if (vec.empty()) continue;

            int scheme_idx = static_cast<int>(vec[0]);   // your 0,1,2,3
            if (scheme_idx == target_idx) {
              selected_vec = &vec;         // remember the correct vector
              selected_name = pair.first;  // remember the name for logging
              break;                       // found it → exit loop early
            }
          }

          // If nothing found (corrupted data?), fall back to first scheme (index 0)
          if (!selected_vec) {
            ESP_LOGW("color_scheme", "Invalid index %d → falling back to default (white)", target_idx);
            for (const auto& pair : id(color_schemes)) {
              const auto& vec = pair.second;
              if (vec.empty()) continue;
              if (static_cast<int>(vec[0]) == 0) {
                selected_vec = &vec;
                selected_name = pair.first;
                id(settings_color_scheme_idx_persistent) = 0;
                break;
              }
            }
          }

          if (selected_vec && selected_vec->size() >= 8) {
            id(color_100)   = (*selected_vec)[1];
            id(color_75)    = (*selected_vec)[2];
            id(color_50)    = (*selected_vec)[3];
            id(color_25)    = (*selected_vec)[4];
            id(color_00)    = (*selected_vec)[5];
            id(color_good)  = (*selected_vec)[6];
            id(color_bad)   = (*selected_vec)[7];
            id(color_light) = (*selected_vec)[8];

            if (${FORCE_SHADOW_COLOR_TO_BLACK}) {
              id(color_00) = 0x000000;
            }

            // THIS SCHOULD BE THE MAGIC LINE: tells every LVGL object that styles changed
            // BUT: DOES NOT WORK at the moment
            lv_obj_report_style_change(NULL);

            ESP_LOGI("color_scheme", "Applied scheme '%s' (index %d)", selected_name.c_str(), target_idx);
          } else {
            ESP_LOGE("color_scheme", "Failed to apply color scheme – data invalid");
          }
      - lambda: |-
          lv_obj_set_style_arc_color(boot_spinner, lv_color_hex(id(color_100)), LV_PART_INDICATOR);

      # Chunk 1: Status bar widgets
      - lvgl.widget.refresh:
          - battery_symbol
          - wifi_connect_label
          - warning_on_label
      - delay: 1ms

      # Chunk 2: Gas widgets
      - lvgl.widget.refresh:
          - gas_level_obj
          - gas_percent_bar
          - gas_warning_mark
          - weight_label_background
          - weight_label
          - weight_unit
          - weight_rate_icon
          - weight_rate_background
          - weight_rate_value
          - weight_rate_unit
          - weight_time_background
          - weight_time_value
          - weight_time_unit
          - weight_time_icon
          - calibration_button
          - calibration_button_label
          - calibration_button_cog_label
          - calibration0_label
          - calibration0_next_button
          - calibration0_next_button_label
          - calibration1_label
          - calibration1_next_button
          - calibration1_next_button_label
          - calibration2_label
          - calibration2_tare_label
          - calibration2_slider
          - calibration2_inc_button
          - calibration2_inc_button_label
          - calibration2_dec_button
          - calibration2_dec_button_label
          - calibration2_ok_button
          - calibration2_ok_button_label
          - calibration3_label
          - calibration3_abort_button
          - calibration3_abort_button_label
          - calibration3_ok_button
          - calibration3_ok_button_label
          - calibration4_label
          - calibration4_understood_button
          - calibration4_understood_button_label
          - calibration_bottle_kg_button_0
          - calibration_bottle_kg_button_0_label
          - calibration_bottle_kg_button_1
          - calibration_bottle_kg_button_1_label
          - calibration_bottle_kg_button_2
          - calibration_bottle_kg_button_2_label
      - delay: 1ms

      # Chunk: Settings page
      - lvgl.widget.refresh:
          - current_wifi_ip_label1
          - current_wifi_ip_label
          - current_version_label1
          - current_version_label2
          - uart_raw_value1
          - uart_raw_value
          - soc_warning_label1
          - soc_warning_label2
          - gas_warning_label1
          - gas_warning_label2
          - color_100_label
          - color_75_label
          - color_50_label
          - color_25_label
          - color_00_label
          - color_good_label
          - color_bad_label
          - color_light_label
      - delay: 1ms

      # Nested slider parts do not pick up a scheme change from widget refresh.
      - lambda: |-
          lv_obj_set_style_bg_color(calibration2_slider, lv_color_hex(id(color_50)), LV_PART_INDICATOR);
          lv_obj_set_style_bg_color(calibration2_slider, lv_color_hex(id(color_100)), LV_PART_KNOB);
          lv_obj_set_style_text_color(calibration2_label, lv_color_hex(id(color_100)), LV_PART_MAIN);
          lv_obj_set_style_text_color(calibration2_tare_label, lv_color_hex(id(color_100)), LV_PART_MAIN);
      - script.execute: style_bottle_kg_buttons

  - id: style_bottle_kg_buttons
    then:
      # checked: styles are applied once at startup, before the scheme exists,
      # and widget refresh does not update them.
      - lambda: |-
          lv_obj_t *buttons[] = {
            calibration_bottle_kg_button_0,
            calibration_bottle_kg_button_1,
            calibration_bottle_kg_button_2,
          };
          const lv_color_t fill = lv_color_hex(id(color_50));
          const lv_style_selector_t states[] = {
            static_cast<lv_style_selector_t>(LV_PART_MAIN | LV_STATE_CHECKED),
            static_cast<lv_style_selector_t>(LV_PART_MAIN | LV_STATE_PRESSED),
            static_cast<lv_style_selector_t>(LV_PART_MAIN | LV_STATE_CHECKED | LV_STATE_PRESSED),
          };
          for (lv_obj_t *button : buttons) {
            for (lv_style_selector_t state : states) {
              lv_obj_set_style_bg_color(button, fill, state);
              lv_obj_set_style_bg_opa(button, LV_OPA_COVER, state);
              lv_obj_set_style_border_color(button, fill, state);
              lv_obj_set_style_border_width(button, 1, state);
              lv_obj_set_style_border_opa(button, LV_OPA_COVER, state);
            }
          }
          lv_obj_set_style_bg_opa(calibration_bottle_kg_button_0_label, LV_OPA_TRANSP, LV_PART_MAIN);
          lv_obj_set_style_bg_opa(calibration_bottle_kg_button_1_label, LV_OPA_TRANSP, LV_PART_MAIN);
          lv_obj_set_style_bg_opa(calibration_bottle_kg_button_2_label, LV_OPA_TRANSP, LV_PART_MAIN);

  - id: show_scale_bottle_kg_selection
    then:
      - lvgl.widget.update:
          id: calibration_bottle_kg_button_0
          state:
            checked: !lambda return id(settings_scale_bottle_kg) == id(scale_bottle_kg_options)[0];
      - lvgl.widget.update:
          id: calibration_bottle_kg_button_1
          state:
            checked: !lambda return id(settings_scale_bottle_kg) == id(scale_bottle_kg_options)[1];
      - lvgl.widget.update:
          id: calibration_bottle_kg_button_2
          state:
            checked: !lambda return id(settings_scale_bottle_kg) == id(scale_bottle_kg_options)[2];
      - lvgl.widget.refresh:
          - calibration_bottle_kg_button_0
          - calibration_bottle_kg_button_0_label
          - calibration_bottle_kg_button_1
          - calibration_bottle_kg_button_1_label
          - calibration_bottle_kg_button_2
          - calibration_bottle_kg_button_2_label
      - script.execute: style_bottle_kg_buttons

  - id: toggle_settings_page
    then:
      - if:
          condition:
            or:
              - lambda: 'return lv_scr_act() == id(scale_page)->obj;'
          then:
            - lvgl.page.show: settings_page
          else:
            - lvgl.page.show: scale_page
