sagdusmir/GasBuddy-Display-320x172/(commit log)

2026-10-03 feature/read-uart
    commit 2d5926bf308ed12e4eb40d641e75c0f93b56b28e
    Author: Jens <jens@michlo.de>
    Date: Sat Oct 3 12:48:05 2026 +0200
    cleanup and rearranged status bar icons
    commit ed6e8f862d0e2808af5ec82c94bb7fd0d176fcaf
    Author: Jens <jens@michlo.de>
    Date: Sat Oct 3 07:11:40 2026 +0200
    some corrections
    commit 5054cdddc7fbe9a1e84f496ded272ebb77c9b722
    Author: Jens <jens@michlo.de>
    Date: Sat Oct 3 06:53:20 2026 +0200
    add uart component
    [gasbuddy-display.yaml]
2026-10-25 Update README to remove power-cycle note
    Remove note about power-cycling the device after flashing.
2026-10-25 Revise power-cycle instructions for device display
    Updated instructions for device reset after flashing.
2026-10-25 Update troubleshooting instructions in README
    Removed outdated power-cycle instruction for device after flashing.
2026-10-26 Add note about connector color customization
    Added a note regarding connector color customization for the LLT-M12-10004F3054.
2026-10-26 Update README to enhance project description
    Clarified the purpose of the repository and added context for users with multiple GasBuddy devices.
2026-10-31 add wiring diagram
2026-10-31 Fix wiring image in README
    Updated wiring image reference in the README.
2026-11-01 Replace old wiring sketch image URL
    Updated wiring sketch image in the README.
2026-11-01 update wiring sketch to be able to power down the scale
2026-11-01 include instructions for custom shield PCB
    [esp32c6-scale-shield-v1.2.kicad_pcb]
2026-11-01 Add image for Home Assistant device page
2026-11-01 Revise component details and case status in README
    Updated component list and details in README.md, including changes to the number of diodes, screws, and buzzers. Marked the case as a work in progress.
2026-11-01 prepare GPIO4 to power down GasBuddy scale
2026-11-01 Clarify Schottky Diode description in README
    Updated the description of the Schottky Diode for clarity.
2026-11-05 add wiring sketch with optional shield pcb
2026-11-05 Update README with custom PCB wiring diagram
    Added wiring diagram for optional custom PCB in README.
2026-11-05 Update wiring sketch image link in README
2026-11-05 Fix image tag for optional custom shield PCB
2026-11-05 Replace wiring sketch image for custom shield PCB
    Updated the wiring sketch image for the optional custom shield PCB.
2026-11-05 tweak wires at the scale side
2026-11-05 Update wiring sketch image in README
2026-11-07 add wiring diagram for powering via usb-c
2026-11-07 Revise wiring instructions in README.md
    Updated wiring instructions for using USB-C and rechargeable battery with optional custom PCB.
2026-11-07 Revise wiring section in README.md
    Updated wiring instructions and added a note about the work in progress status.
2026-11-07 Enhance connector description in README
    Updated the description for the LLT-M12-10004F3054 connector to encourage users to reach out for assistance.
2026-11-07 Add hyperlink to contact information for connector
    Updated the contact information for the LLT-M12-10004F3054 connector to include a hyperlink.
2026-11-07 Fix typo in wiring description for rechargeable battery
2026-11-08 add strain relief 3d model
    [strain relief v7.3mf, strain relief v7.step]
2026-11-08 Update README with strain relief description
    Added description for strain relief for GasBuddy scale PCB.
2026-11-08 add images of printed strain relief 3d model
    [strain relief v7.3mf, strain relief v7.step]
2026-11-11 Enhance README with wiring instructions
    Added wiring instructions for using USB-C and rechargeable battery options.
2026-11-11 Enhance README with battery wiring suggestions
    Added suggestions for wiring with a rechargeable battery.
2026-11-11 version bump tp 1.1.0
    - more logging
    - power down the GasBuddy when the backglight is off and no reading is required (power save)
    - read the weight only once every 2 minutes when the backglight is off
2026-11-13 Update README for clarity and remove WIP notes
    Removed 'WORK IN PROGRESS' note from the title and updated optional items in the materials list. Added details about the custom PCB shield and clarified the enclosure status.
2026-11-13 Replace custom shield PCB closeup image in README
    Updated README with a new image for the custom shield PCB closeup.
2026-11-13 Fix image title in README for custom shield PCB
    Correct the title attribute in the image tag for clarity.
2026-11-13 Update README with Pololu S7V8F5 mounting options
    Added information about mounting options for the Pololu S7V8F5.
2026-11-13 Update README with new images for device features
    Added additional images for device features and calibration wizards.
